Yadukrishnan-KM/automated-solar-dryer-controller-esp32/Final_product_images/IMG_20220216_131751.jpg

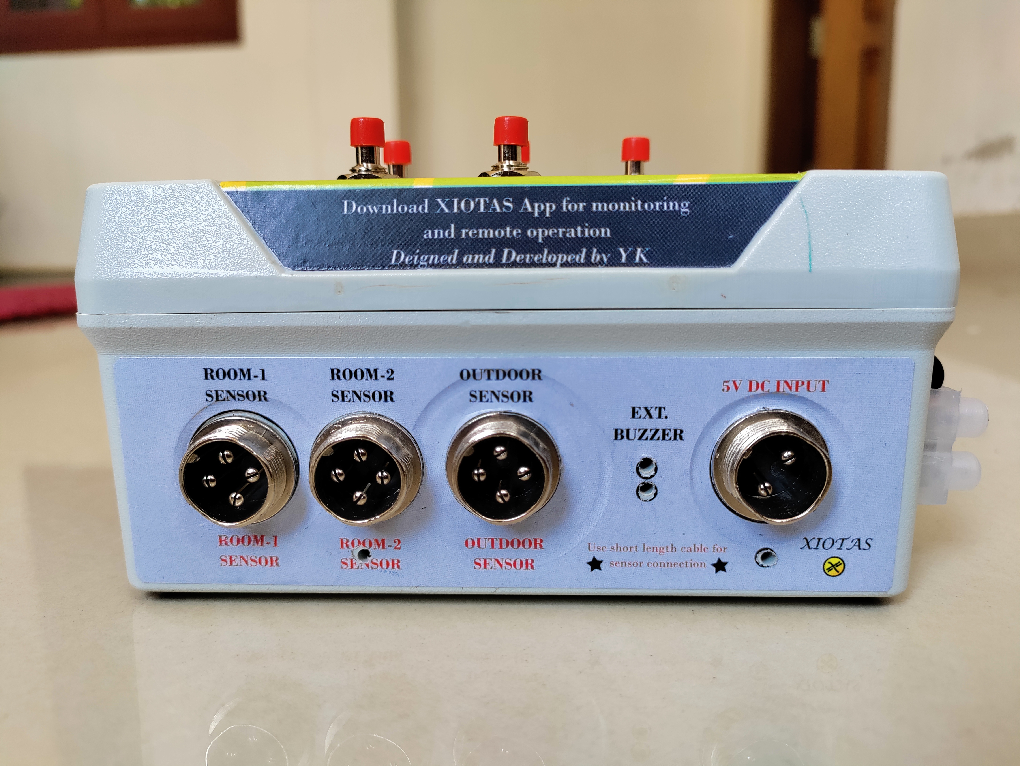
Final_product_images/IMG_20220216_131751.jpg
