Yadukrishnan-KM/automated-solar-dryer-controller-esp32/Final_product_images/IMG_20220226_195927.jpg

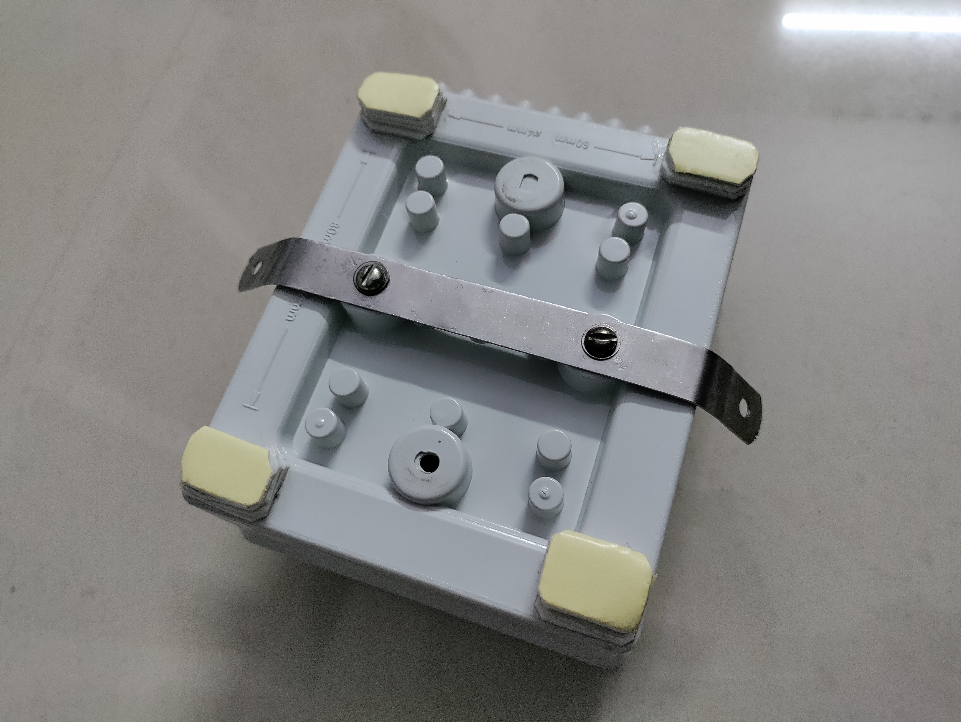
Final_product_images/IMG_20220226_195927.jpg
