Yadukrishnan-KM/automated-solar-dryer-controller-esp32/Firmware/RTC chart.png

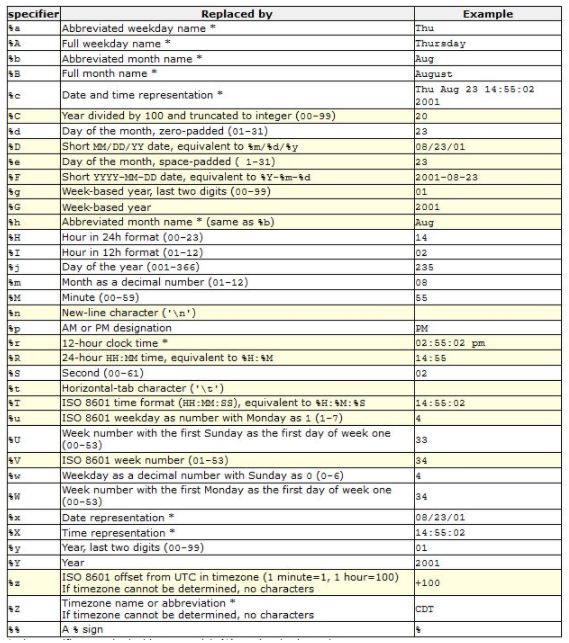
Firmware/RTC chart.png
