Yadukrishnan-KM/automated-solar-dryer-controller-esp32/Hardware/Circuit and pinouts/onoff digital switch circuit diagram.png

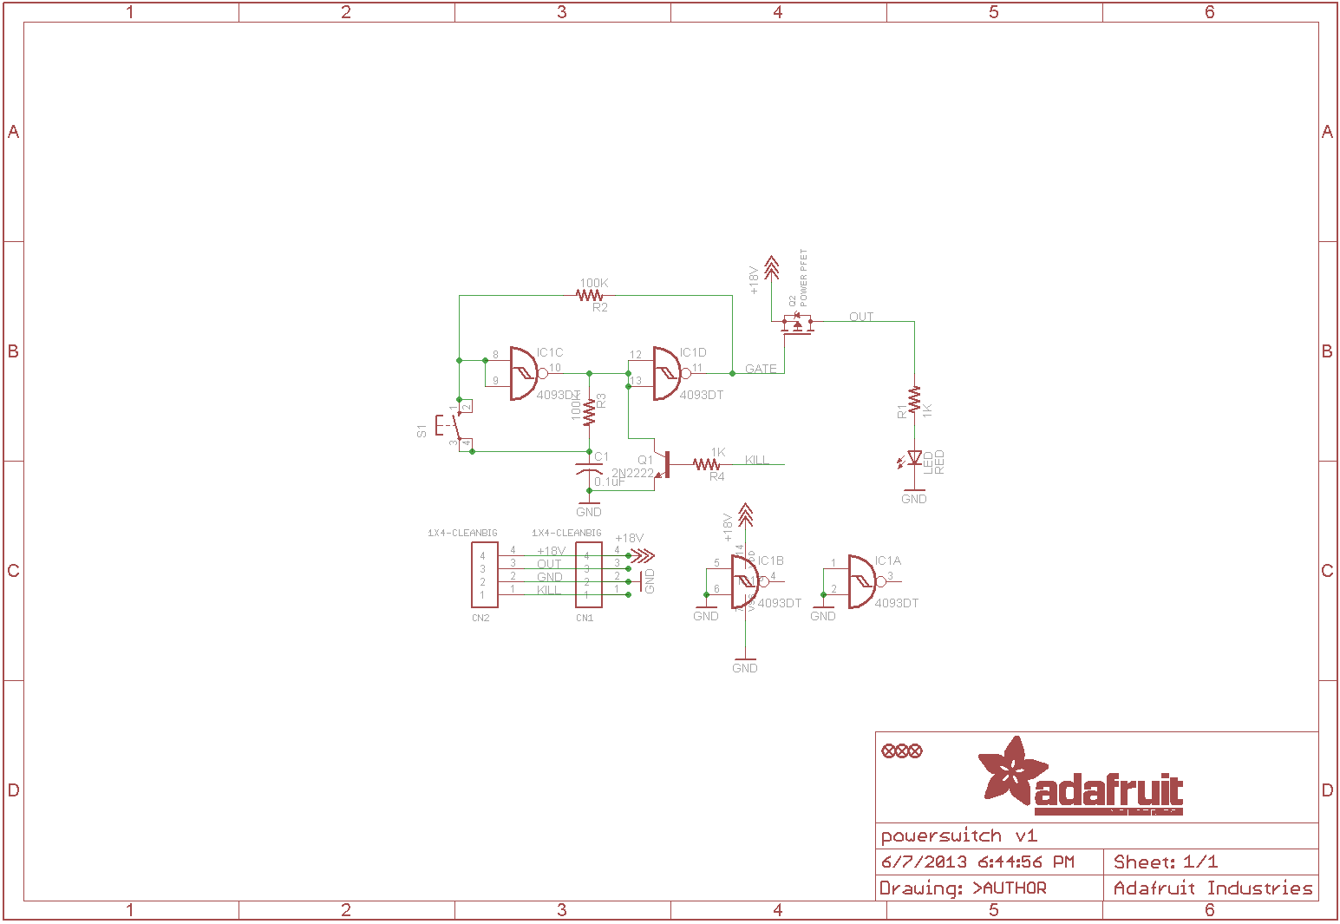
Hardware/Circuit and pinouts/onoff digital switch circuit diagram.png
