Yadukrishnan-KM/automated-solar-dryer-controller-esp32/Hardware/Datasheet/SHT20 Sensor data/wire-diagram.jpg

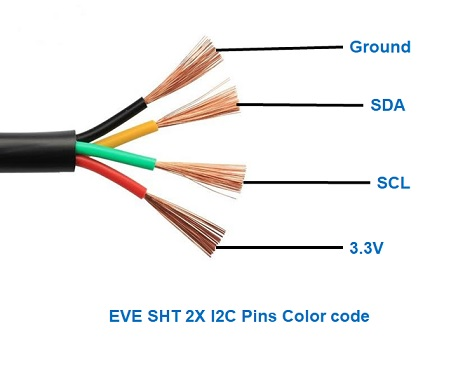
Hardware/Datasheet/SHT20 Sensor data/wire-diagram.jpg
