Yadukrishnan-KM/automated-solar-dryer-controller-esp32/Hardware/Images/IMG-20211218-WA0000.jpeg

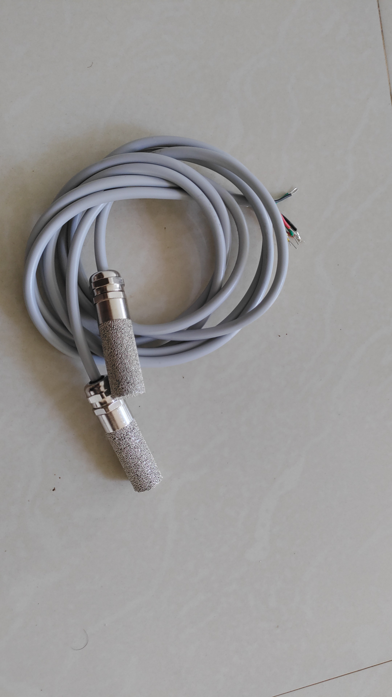
Hardware/Images/IMG-20211218-WA0000.jpeg
