Yadukrishnan-KM/automated-solar-dryer-controller-esp32/Hardware/Images/IMG-20220211-WA0001.jpeg

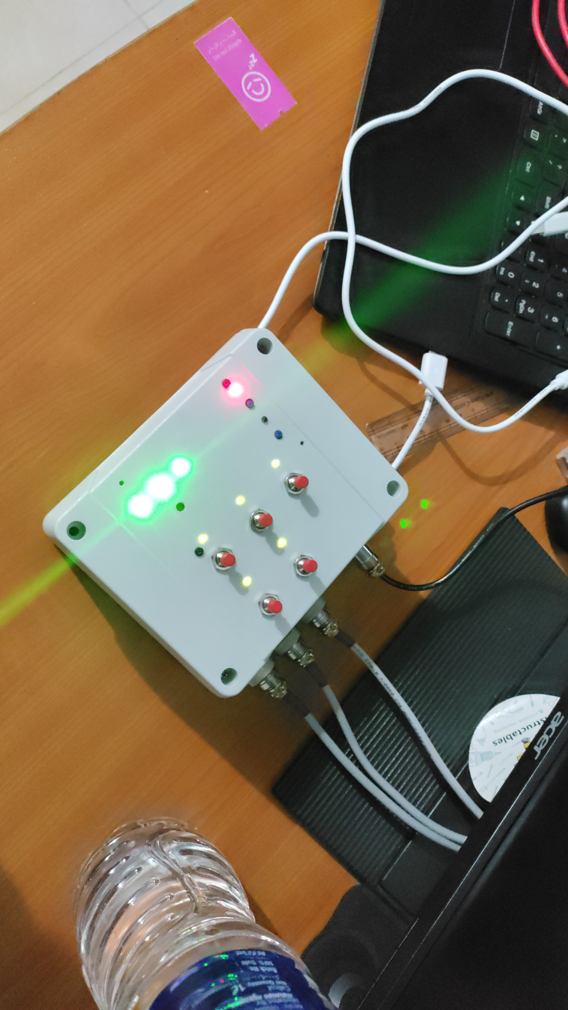
Hardware/Images/IMG-20220211-WA0001.jpeg
