Yadukrishnan-KM/automated-solar-dryer-controller-esp32/Hardware/Images/IMG_20220204_172352.jpg

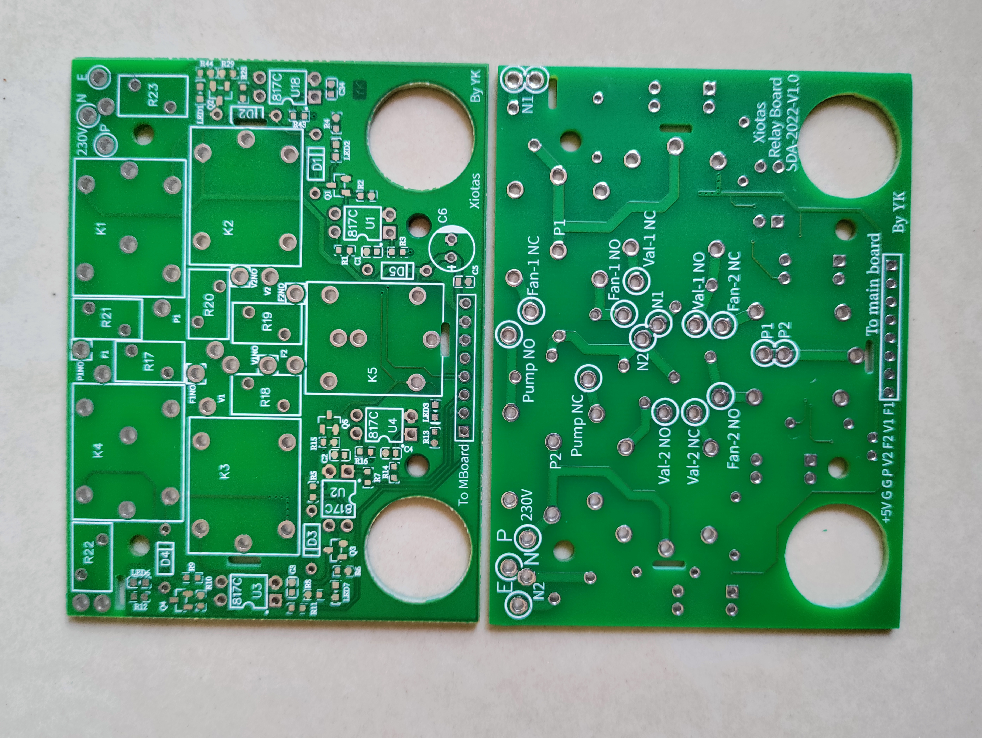
Hardware/Images/IMG_20220204_172352.jpg
