Yadukrishnan-KM/automated-solar-dryer-controller-esp32/Hardware/Images/IMG_20220206_123205.jpg

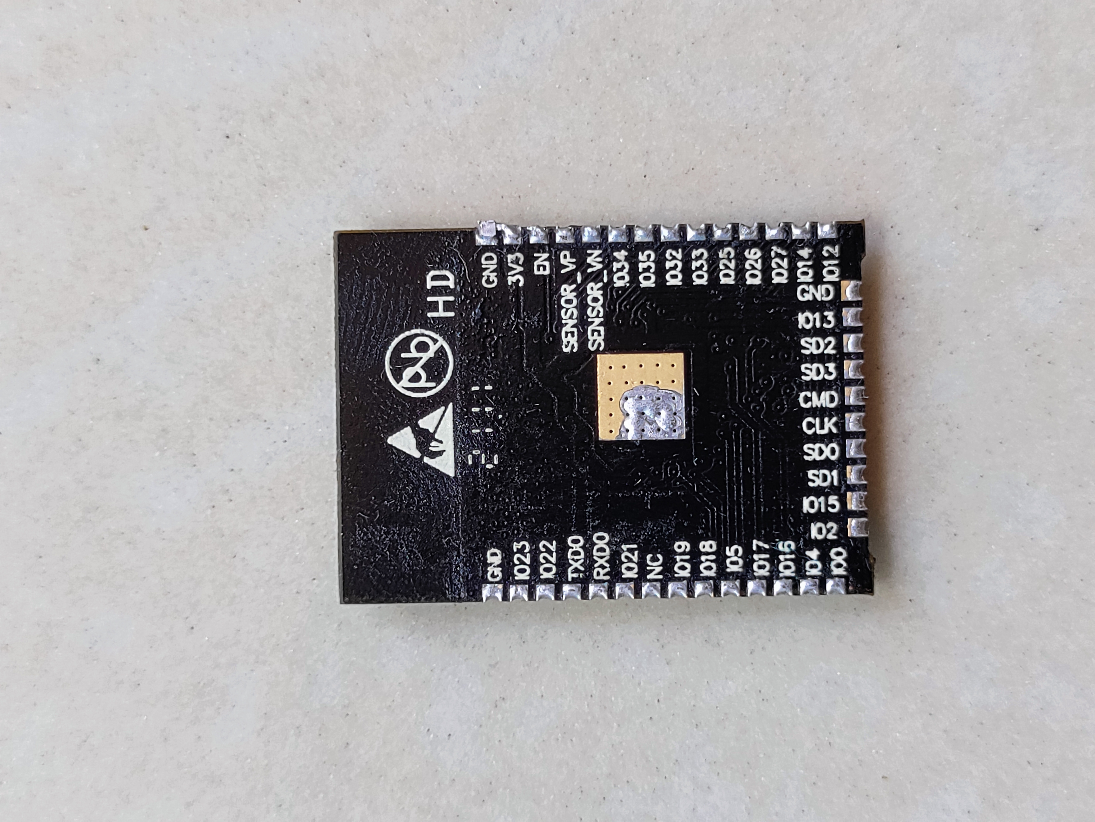
Hardware/Images/IMG_20220206_123205.jpg
