Yadukrishnan-KM/automated-solar-dryer-controller-esp32/Hardware/Images/IMG_20220206_123243.jpg

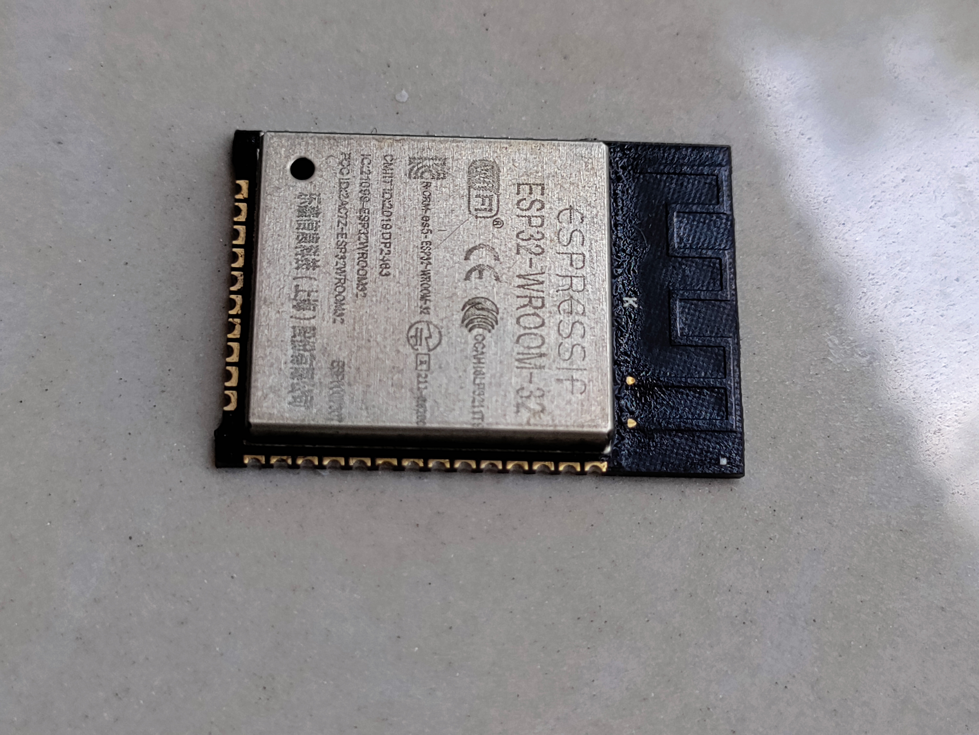
Hardware/Images/IMG_20220206_123243.jpg
