Yadukrishnan-KM/automated-solar-dryer-controller-esp32/Hardware/Images/IMG_20220206_151241.jpg

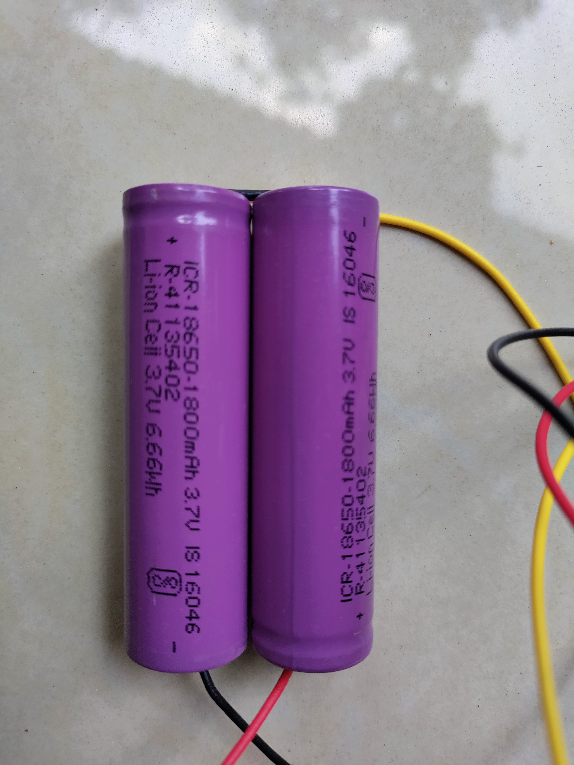
Hardware/Images/IMG_20220206_151241.jpg
