Yadukrishnan-KM/automated-solar-dryer-controller-esp32/Hardware/Images/IMG_20220207_124142.jpg

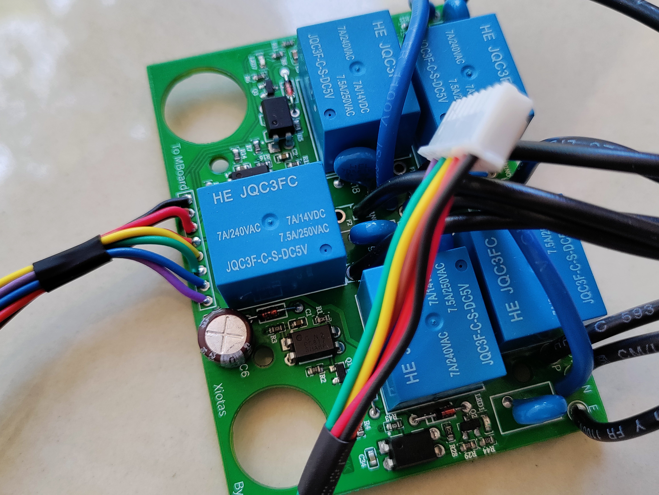
Hardware/Images/IMG_20220207_124142.jpg
