Yadukrishnan-KM/automated-solar-dryer-controller-esp32/Hardware/Images/IMG_20220207_124150.jpg

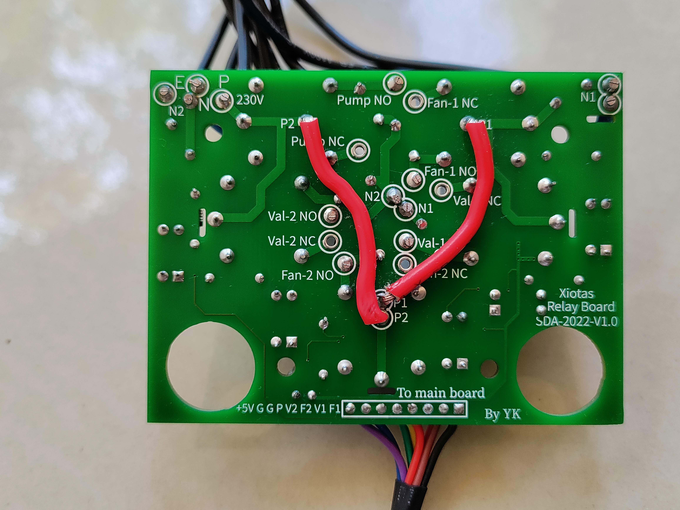
Hardware/Images/IMG_20220207_124150.jpg
