Yadukrishnan-KM/automated-solar-dryer-controller-esp32/Hardware/Images/IMG_20220207_141834.jpg

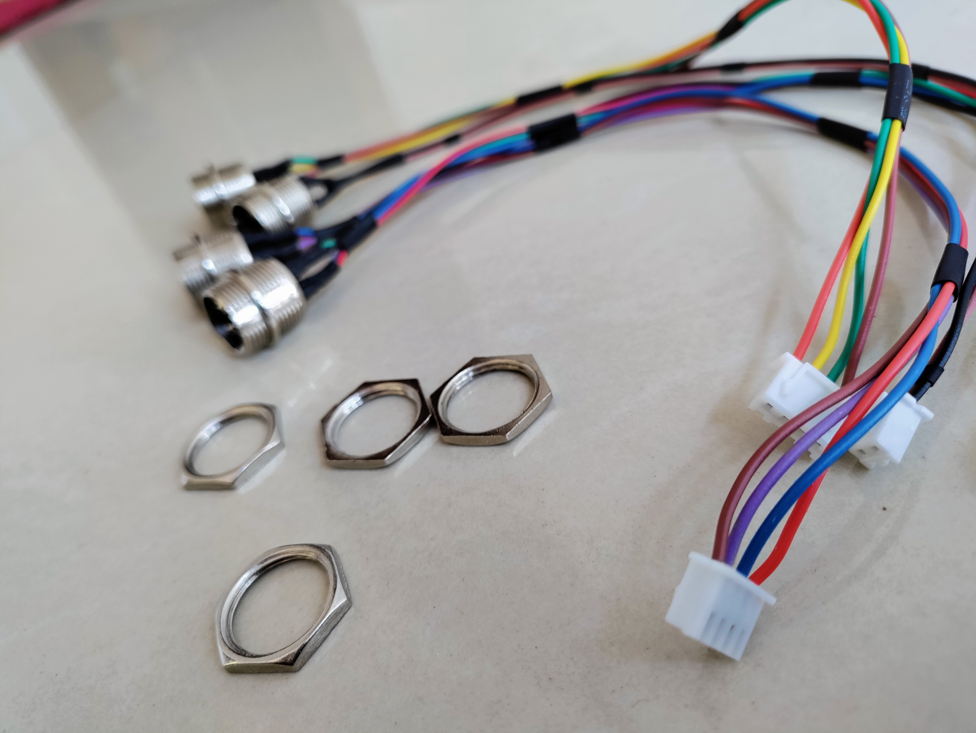
Hardware/Images/IMG_20220207_141834.jpg
