Yadukrishnan-KM/automated-solar-dryer-controller-esp32/Hardware/Images/IMG_20220207_143715.jpg

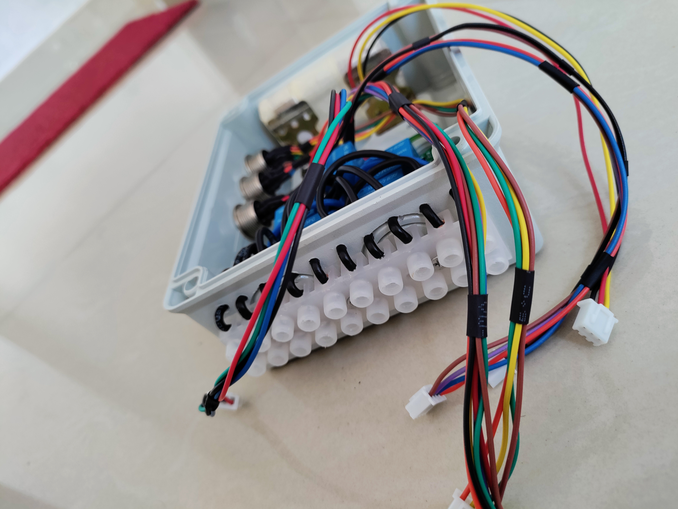
Hardware/Images/IMG_20220207_143715.jpg
