Yadukrishnan-KM/automated-solar-dryer-controller-esp32/Hardware/Images/IMG_20220207_160404.jpg

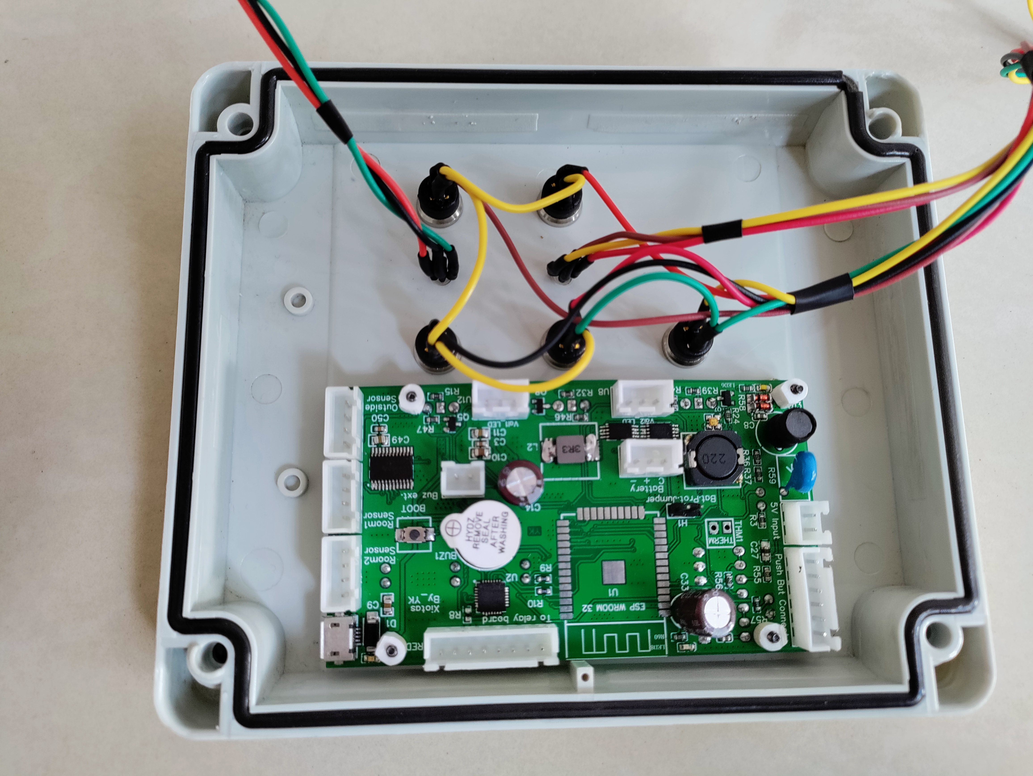
Hardware/Images/IMG_20220207_160404.jpg
