Yadukrishnan-KM/automated-solar-dryer-controller-esp32/Hardware/Images/IMG_20220207_160421.jpg

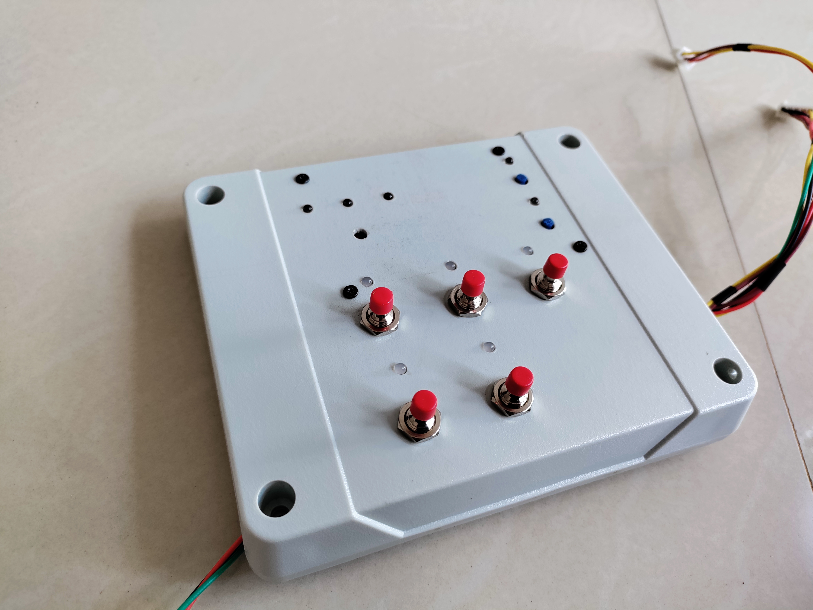
Hardware/Images/IMG_20220207_160421.jpg
