Yadukrishnan-KM/automated-solar-dryer-controller-esp32/Hardware/Images/IMG_20220207_161312.jpg

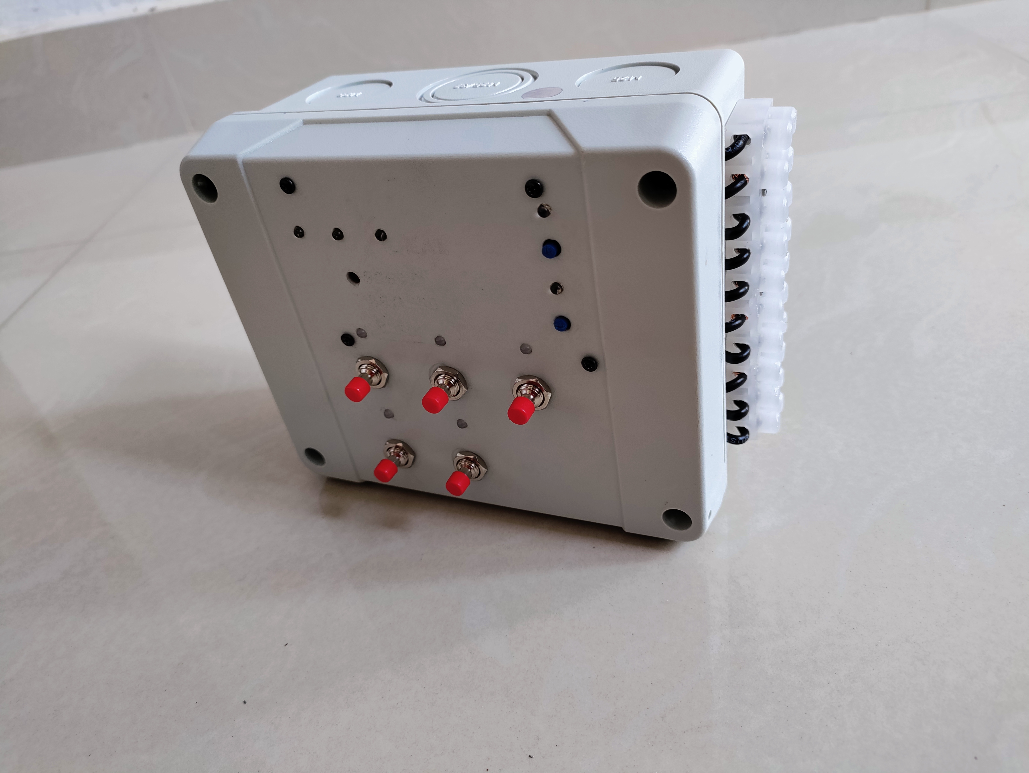
Hardware/Images/IMG_20220207_161312.jpg
