Yadukrishnan-KM/automated-solar-dryer-controller-esp32/Hardware/Images/IMG_20220207_173743.jpg

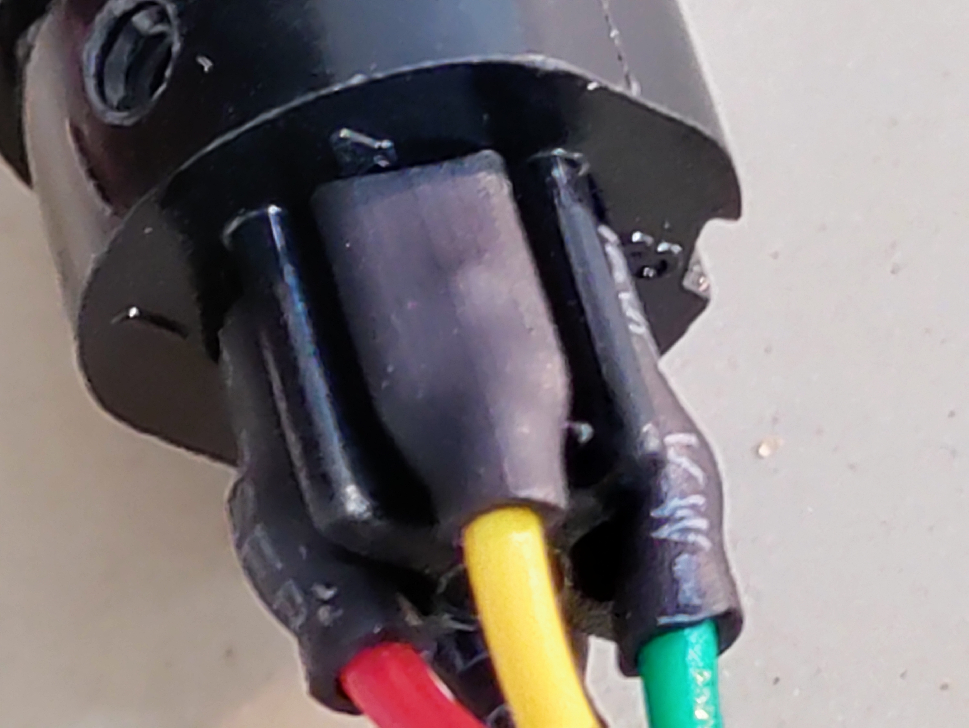
Hardware/Images/IMG_20220207_173743.jpg
