Yadukrishnan-KM/automated-solar-dryer-controller-esp32/Hardware/Images/IMG_20220209_073930.jpg

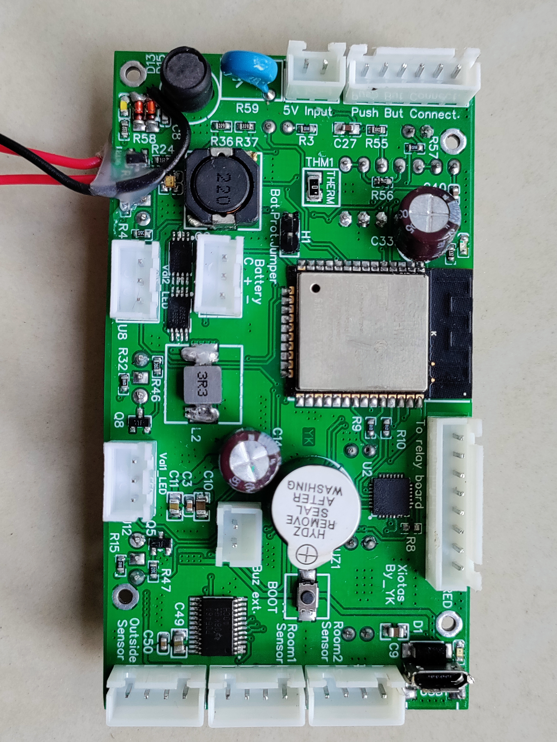
Hardware/Images/IMG_20220209_073930.jpg
