Yadukrishnan-KM/automated-solar-dryer-controller-esp32/Hardware/Images/IMG_20220209_074030.jpg

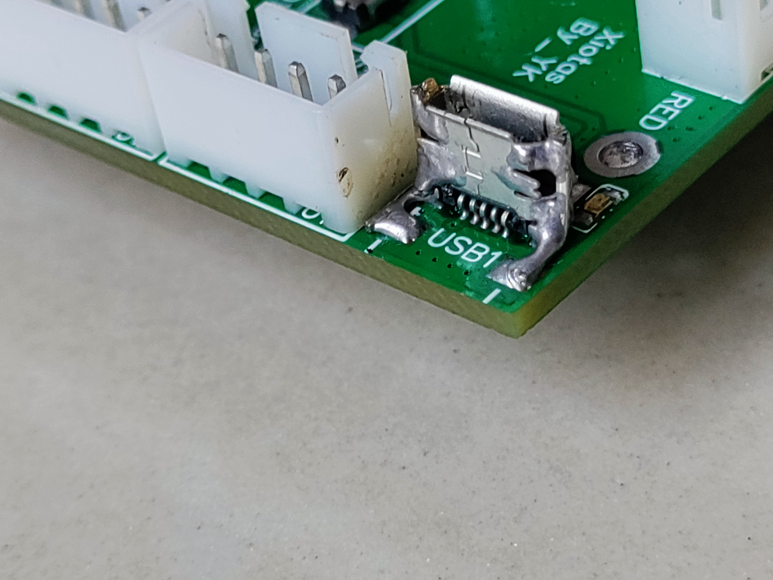
Hardware/Images/IMG_20220209_074030.jpg
