Yadukrishnan-KM/automated-solar-dryer-controller-esp32/Hardware/Images/IMG_20220216_074443.jpg

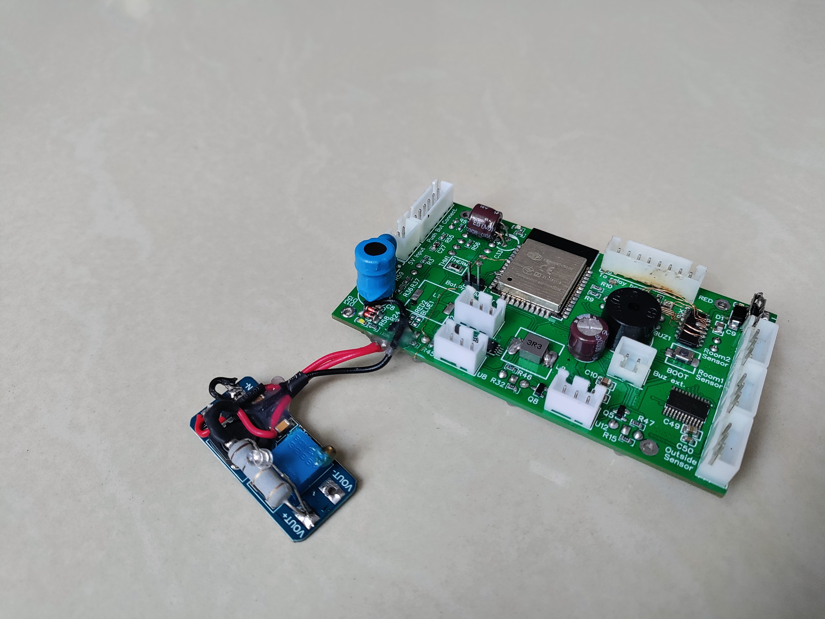
Hardware/Images/IMG_20220216_074443.jpg
