Yadukrishnan-KM/automated-solar-dryer-controller-esp32/Hardware/Images/IMG_20220216_074451.jpg

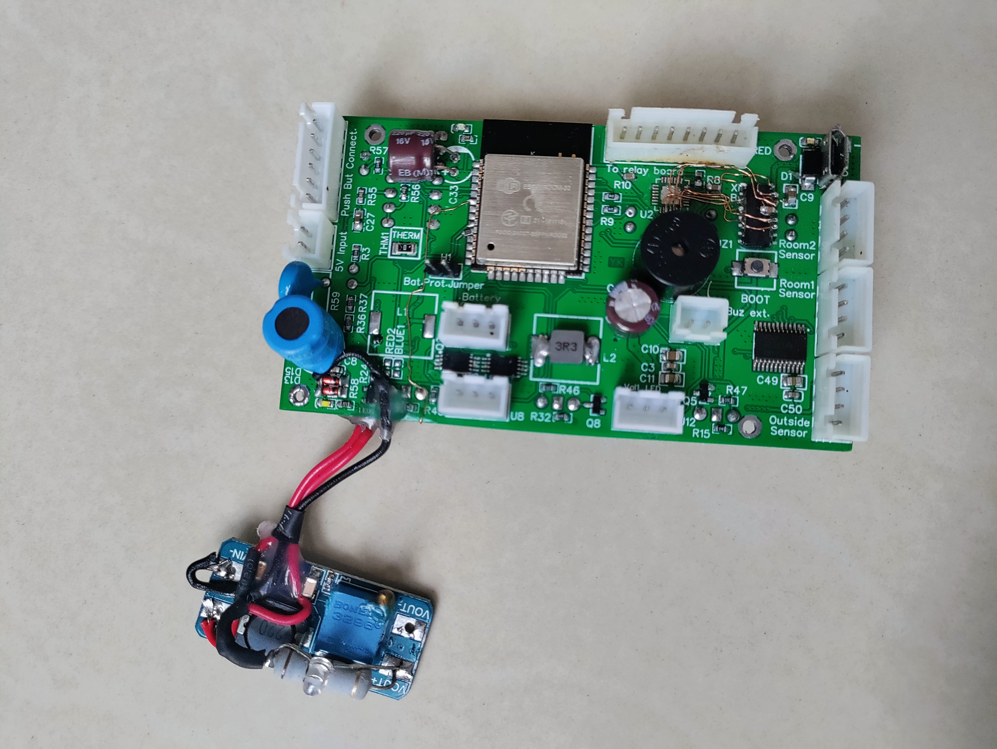
Hardware/Images/IMG_20220216_074451.jpg
