Yadukrishnan-KM/automated-solar-dryer-controller-esp32/Hardware/Images/IMG_20220216_082156.jpg

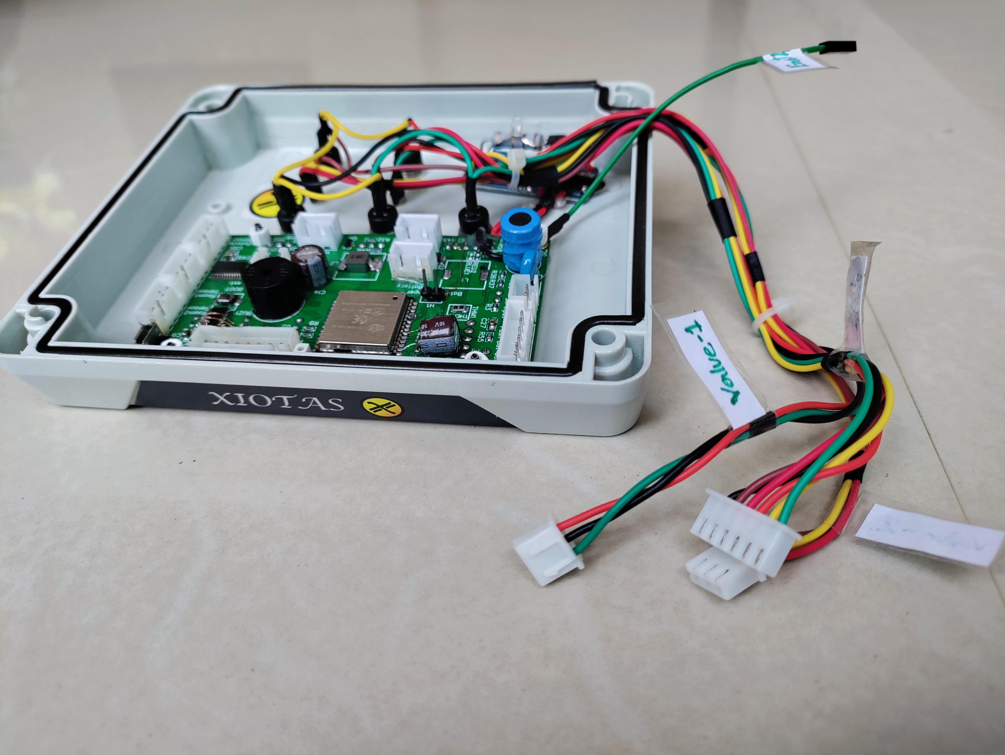
Hardware/Images/IMG_20220216_082156.jpg
