Yadukrishnan-KM/automated-solar-dryer-controller-esp32/Hardware/Images/IMG_20220217_221502.jpg

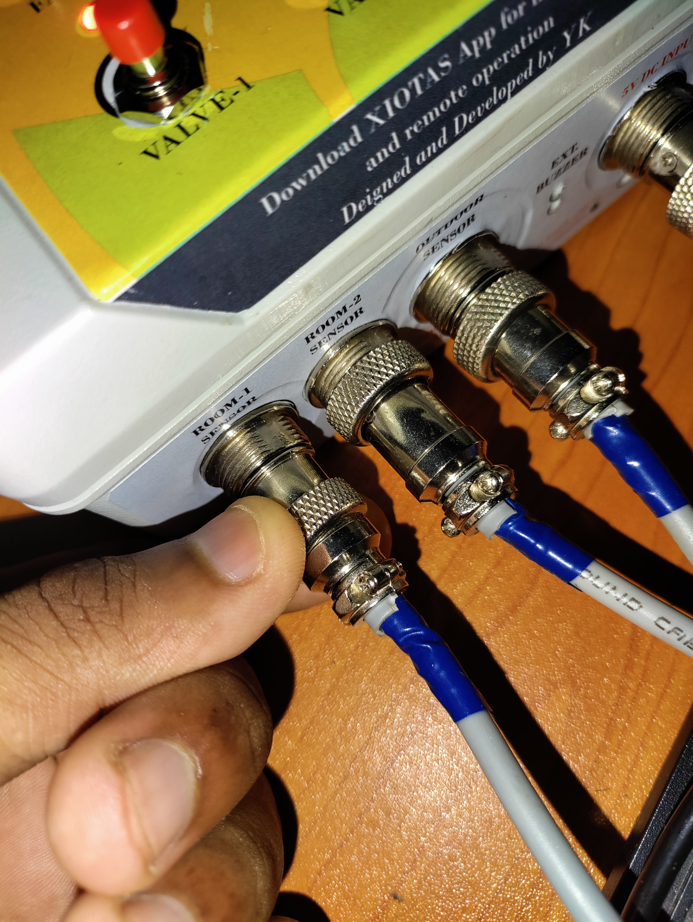
Hardware/Images/IMG_20220217_221502.jpg
