Yadukrishnan-KM/automated-solar-dryer-controller-esp32/Hardware/Images/IMG_20220221_131127.jpg

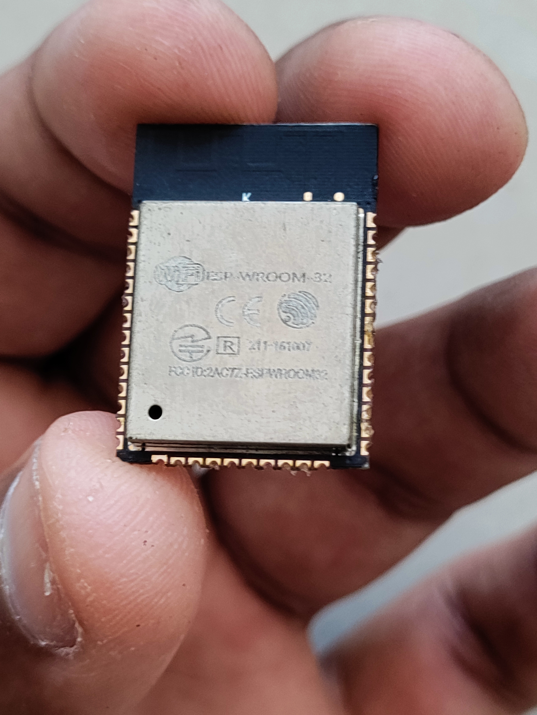
Hardware/Images/IMG_20220221_131127.jpg
