Yadukrishnan-KM/automated-solar-dryer-controller-esp32/Hardware/PCBs Layout/MainPCB_BottomSide.png

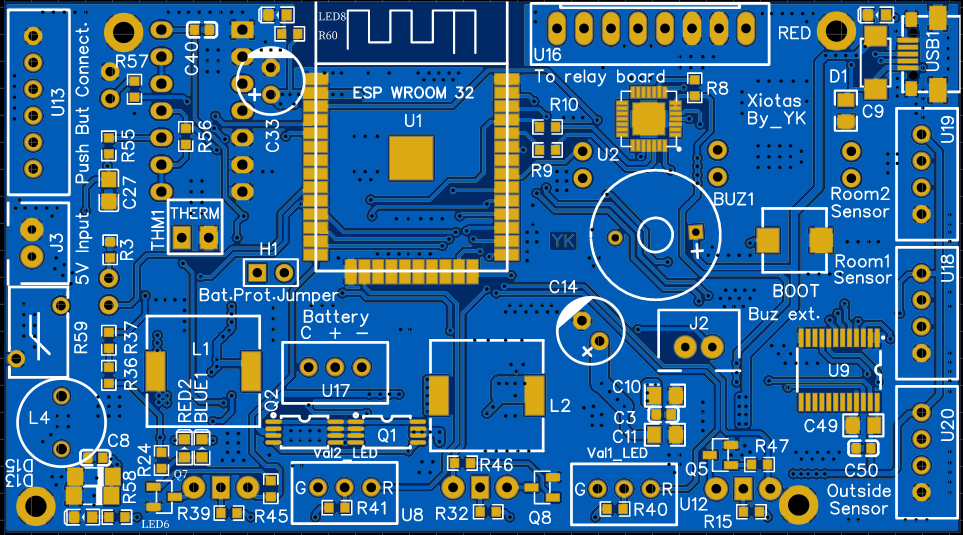
Hardware/PCBs Layout/MainPCB_BottomSide.png
