Yadukrishnan-KM/automated-solar-dryer-controller-esp32/Hardware/PCBs Layout/MainPCB_FrontSide.png

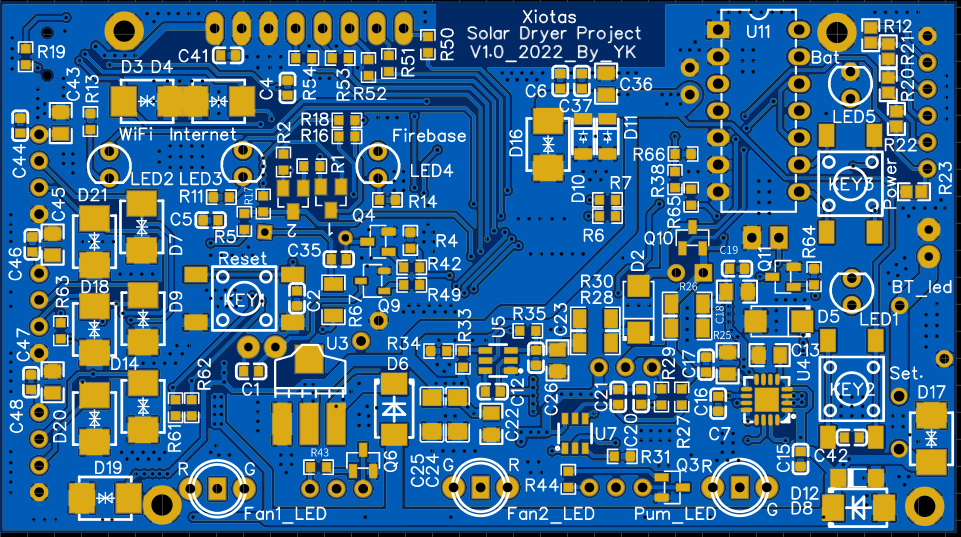
Hardware/PCBs Layout/MainPCB_FrontSide.png
