Yadukrishnan-KM/automated-solar-dryer-controller-esp32/Hardware/PCBs Layout/RelayCntrlPCB_BottomSide.png

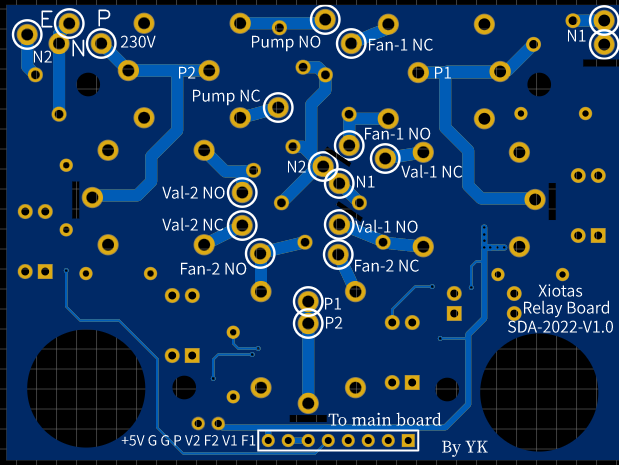
Hardware/PCBs Layout/RelayCntrlPCB_BottomSide.png
