Yadukrishnan-KM/automated-solar-dryer-controller-esp32/Hardware/Schematic_Xiotas_Solar_Dryer_Version_0.1_2022-02-09.png

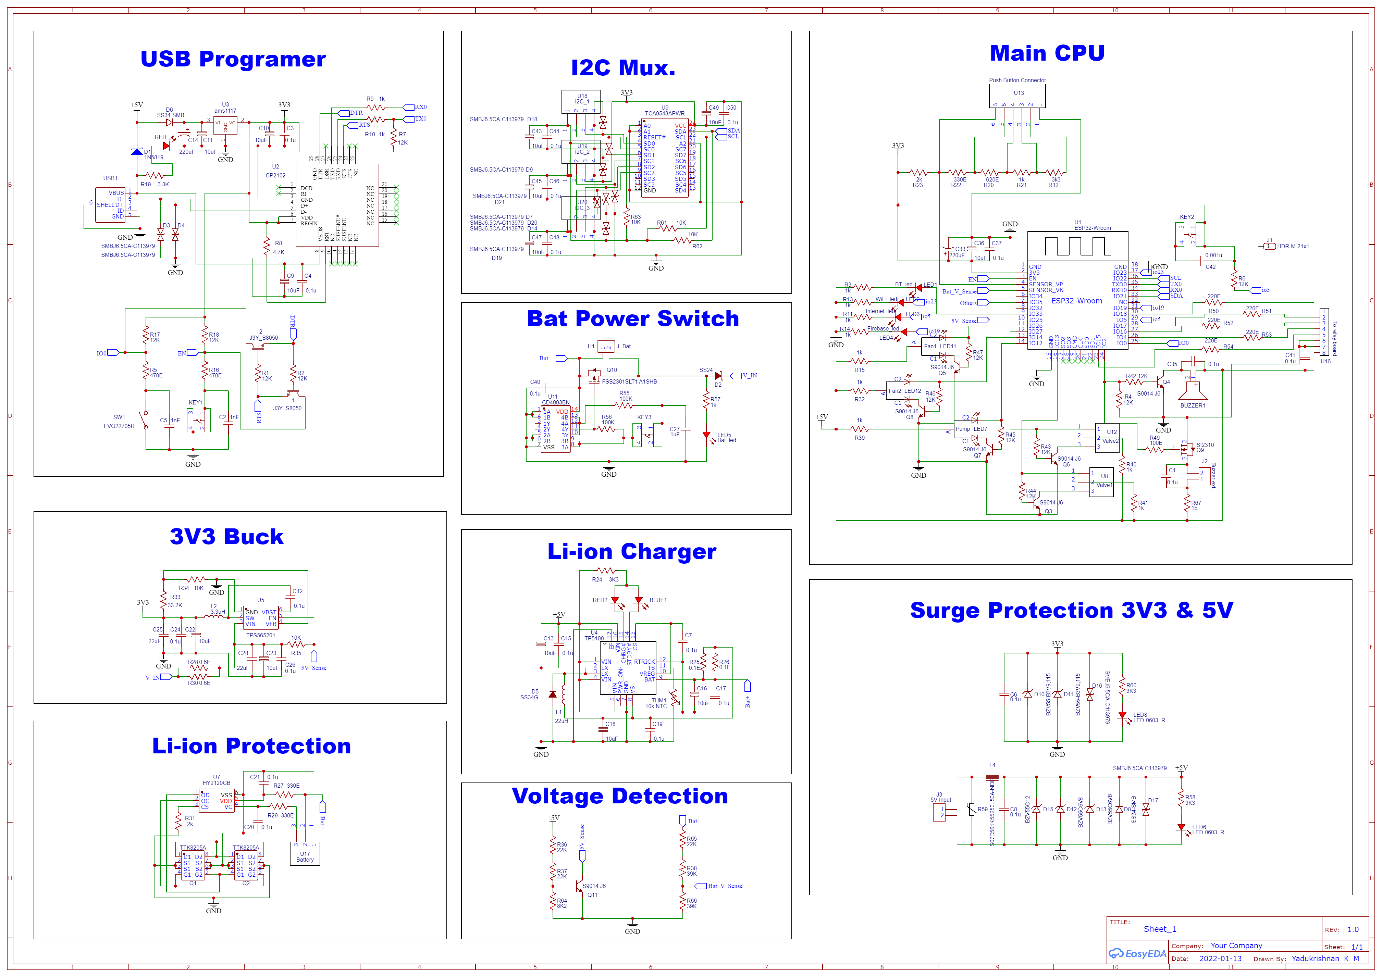
Hardware/Schematic_Xiotas_Solar_Dryer_Version_0.1_2022-02-09.png
