Yadukrishnan-KM/automated-solar-dryer-controller-esp32/Hardware/BOM_PCB_Xiotas_Solar_Dryer_Version_0.1_2022-02-04.csv

쎃슃쎂슃쎃슂쎂슃쎃슃쎂슂쎃슂쎂슿쎃슃쎂슃쎃슂쎂슃쎃슃쎂슂쎃슂쎂슾䤀䐀ⰬName | Designator | Footprint | Quantity | Manufacturer Part
ਢ"∀㄀∢"Ⱜ∀∢0.1u"∀∬∀∢C3 | C8 | C40 | C50 | C46 | C48 | C1 | C4 | C6 | C7 | C12 | C15 | C17 | C19 | C20 | C21 | C26 | C35 | C37 | C41 | C44"∀∬∀∢C0603"∀∬∀∢21"∀∬∀∢"∀∍ਢ"∀㈀∢"Ⱜ∀∢S9014 J6"∀∬∀∢Q5 | Q7 | Q8 | Q3 | Q6 | Q4 | Q11"∀∬∀∢SOT-23-3_L2.9-W1.3-P1.90-LS2.4-BR"∀∬∀∢7"∀∬∀∢S9014LT1 (S9014 J6)"∀∍ਢ"∀㌀∢"Ⱜ∀∢1k"∀∬∀∢R40 | R41 | R3 | R57 | R15 | R32 | R39 | R9 | R10 | R11 | R13 | R14"∀∬∀∢R0603"∀∬∀∢12"∀∬∀∢"∀∍ਢ"∀㐀∢"Ⱜ∀∢LED-0603_R"∀∬∀∢LED8 | LED6 | BLUE1 | RED2 | RED"∀∬∀∢LED0603_RED"∀∬∀∢5"∀∬∀∢19-217/R6C-AL1M2VY/3T"∀∍ਢ"∀㔀∢"Ⱜ∀∢3K3"∀∬∀∢R60 | R58"∀∬∀∢R0603"∀∬∀∢2"∀∬∀∢"∀∍ਢ"∀㘀∢"Ⱜ∀∢10k NTC"∀∬∀∢THM1"∀∬∀∢THERMISTOR"∀∬∀∢1"∀∬∀∢?"∀∍ਢ"∀㜀∢"Ⱜ∀∢10uF"∀∬∀∢C9 | C10 | C11 | C49 | C45 | C47 | C43 | C13 | C16 | C18 | C22 | C23 | C36"∀∬∀∢0805"∀∬∀∢13"∀∬∀∢"∀∍ਢ"∀㠀∢"Ⱜ∀∢TTK8205A"∀∬∀∢Q1 | Q2"∀∬∀∢TSSOP-8_L4.4-W3.0-P0.65-LS6.4-BL"∀∬∀∢2"∀∬∀∢TTK8205A"∀∍ਢ"∀㤀∢"Ⱜ∀∢BZV55C6V8"∀∬∀∢D13 | D12"∀∬∀∢SOD-80_L3.5-W1.5-RD"∀∬∀∢2"∀∬∀∢BZV55C6V8"∀∍ਢ"∀㄀ ∢"Ⱜ∀∢BZV55C12"∀∬∀∢D15"∀∬∀∢SOD-80_L3.5-W1.5-RD"∀∬∀∢1"∀∬∀∢BZV55C12"∀∍ਢ"∀㄀㄀∢"Ⱜ∀∢22K"∀∬∀∢R36 | R37 | R65"∀∬∀∢R0603"∀∬∀∢3"∀∬∀∢"∀∍ਢ"∀㄀㈀∢"Ⱜ∀∢1N5819"∀∬∀∢D1"∀∬∀∢SMA/DO-214AC"∀∬∀∢1"∀∬∀∢"∀∍ਢ"∀㄀㌀∢"Ⱜ∀∢100K"∀∬∀∢R55 | R56"∀∬∀∢R0603"∀∬∀∢2"∀∬∀∢"∀∍ਢ"∀㄀㐀∢"Ⱜ∀∢1uF"∀∬∀∢C27"∀∬∀∢C0805"∀∬∀∢1"∀∬∀∢"∀∍ਢ"∀㄀㔀∢"Ⱜ∀∢Bat.Prot.Jumper"∀∬∀∢H1"∀∬∀∢HDR-F-2.54_1X2"∀∬∀∢1"∀∬∀∢"∀∍ਢ"∀㄀㘀∢"Ⱜ∀∢Buz ext."∀∬∀∢J2"∀∬∀∢JST-2.54-2PIN"∀∬∀∢1"∀∬∀∢"∀∍ਢ"∀㄀㜀∢"Ⱜ∀∢5V Input"∀∬∀∢J3"∀∬∀∢JST-2.54-2PIN"∀∬∀∢1"∀∬∀∢"∀∍ਢ"∀㄀㠀∢"Ⱜ∀∢Valve1"∀∬∀∢U8"∀∬∀∢JST-XH-3PIN"∀∬∀∢1"∀∬∀∢"∀∍ਢ"∀㄀㤀∢"Ⱜ∀∢Valve2"∀∬∀∢U12"∀∬∀∢JST-XH-3PIN"∀∬∀∢1"∀∬∀∢"∀∍ਢ"∀㈀ ∢"Ⱜ∀∢Push But Connect."∀∬∀∢U13"∀∬∀∢JST-XH-6PIN"∀∬∀∢1"∀∬∀∢"∀∍ਢ"∀㈀㄀∢"Ⱜ∀∢To relay board"∀∬∀∢U16"∀∬∀∢JST-XHP-8-PIN"∀∬∀∢1"∀∬∀∢"∀∍ਢ"∀㈀㈀∢"Ⱜ∀∢Battery"∀∬∀∢U17"∀∬∀∢JST-XH-3PIN"∀∬∀∢1"∀∬∀∢"∀∍ਢ"∀㈀㌀∢"Ⱜ∀∢I2C_1"∀∬∀∢U18"∀∬∀∢JST-XH-4PIN"∀∬∀∢1"∀∬∀∢"∀∍ਢ"∀㈀㐀∢"Ⱜ∀∢I2C_2"∀∬∀∢U19"∀∬∀∢JST-XH-4PIN"∀∬∀∢1"∀∬∀∢"∀∍ਢ"∀㈀㔀∢"Ⱜ∀∢I2C_3"∀∬∀∢U20"∀∬∀∢JST-XH-4PIN"∀∬∀∢1"∀∬∀∢"∀∍ਢ"∀㈀㘀∢"Ⱜ∀∢12K"∀∬∀∢R45
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
