Yadukrishnan-KM/automated-solar-dryer-controller-esp32/Stickers/A4 sticker for printing.pdf

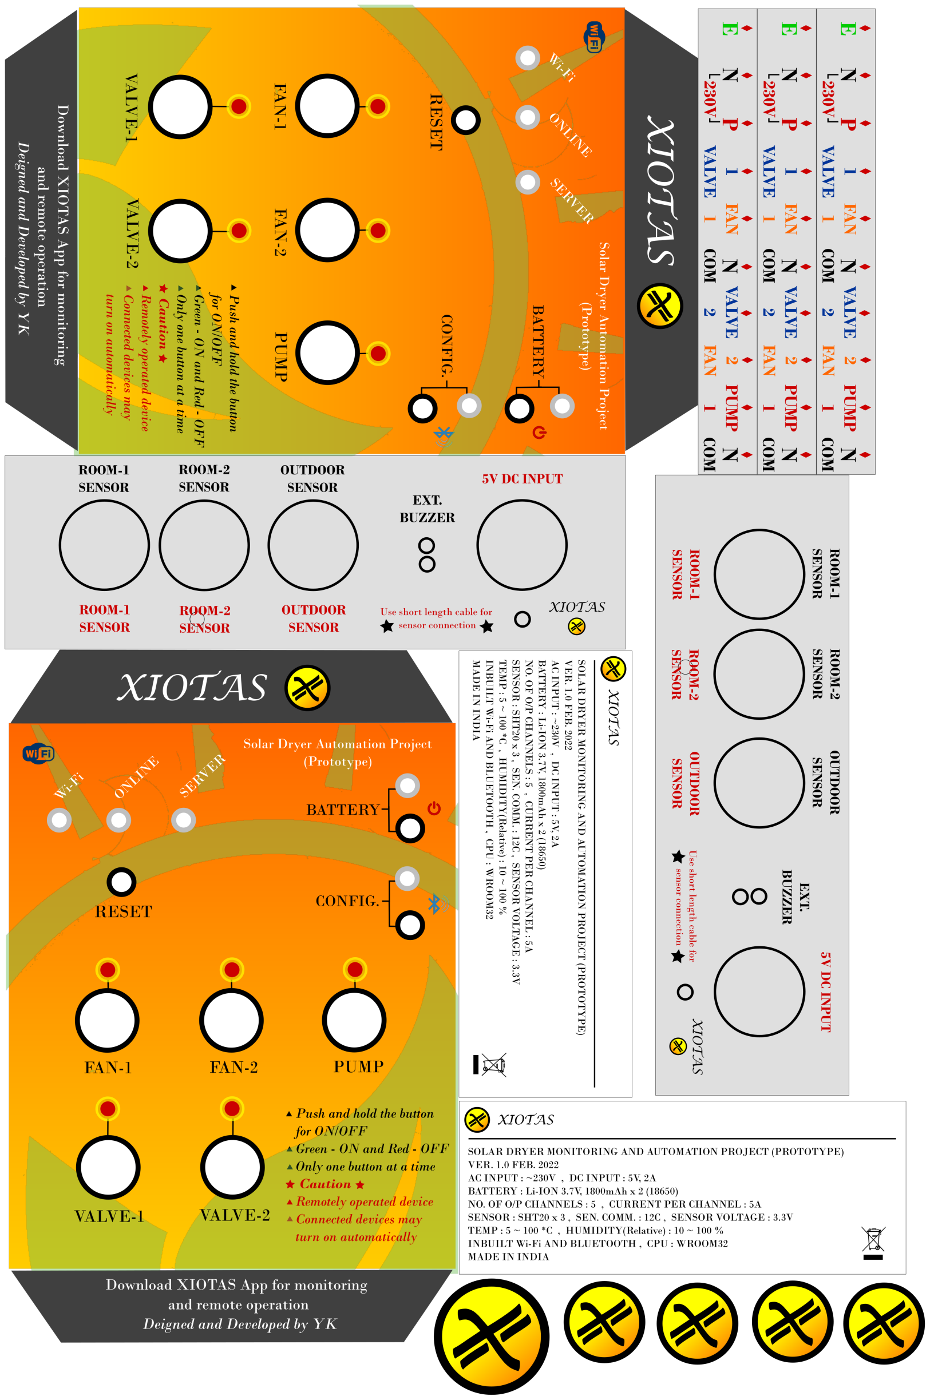
[picture p157: page 1]
