Yadukrishnan-KM/automated-solar-dryer-controller-esp32/Manual/Manual images/Sigin page.png

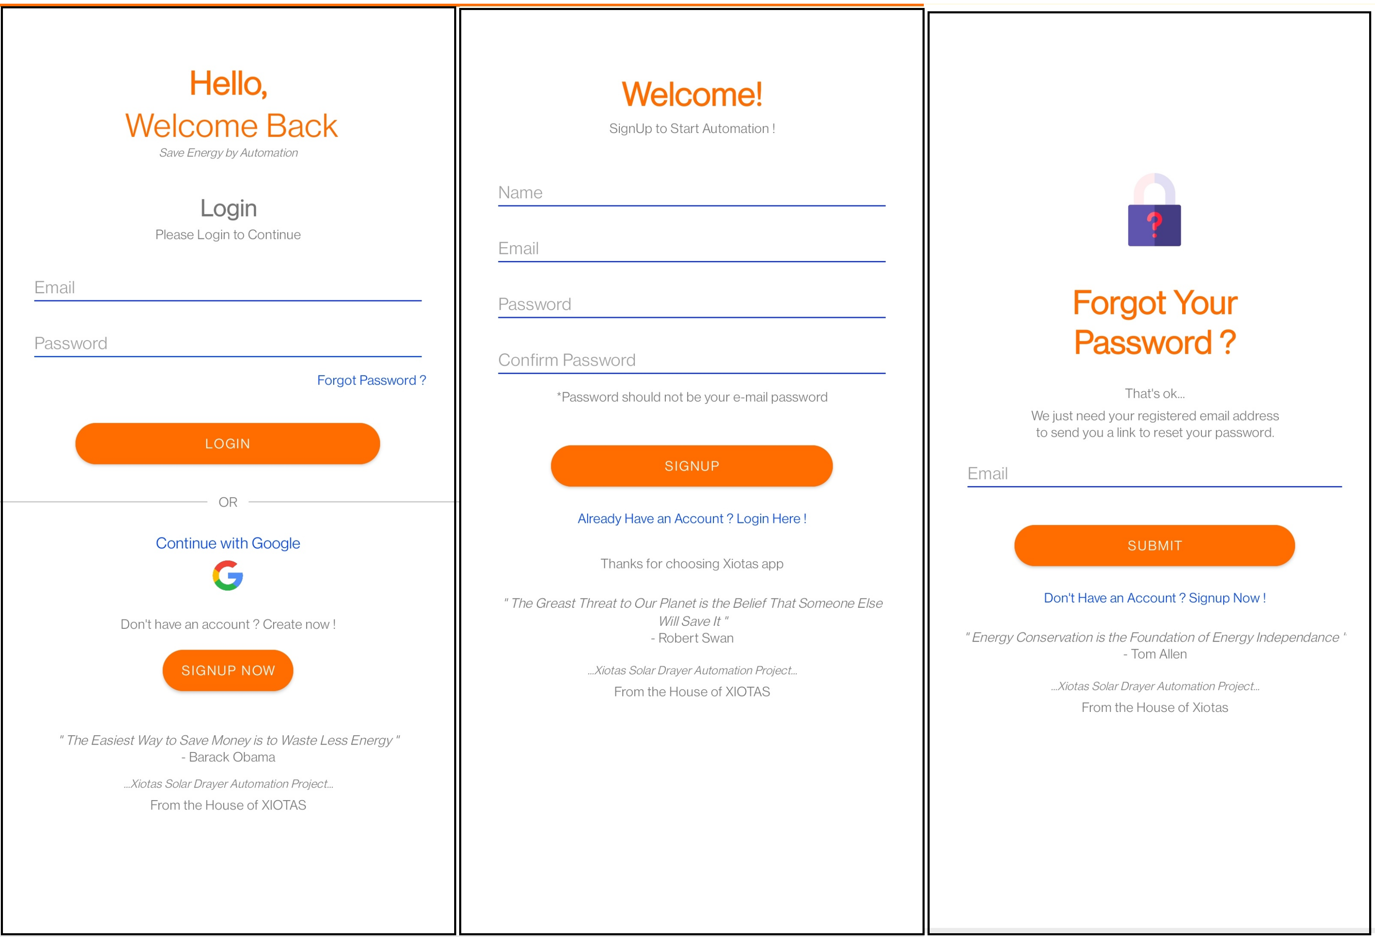
Manual/Manual images/Sigin page.png
