Yadukrishnan-KM/automated-solar-dryer-controller-esp32/Stickers/A4sticker for printing.png

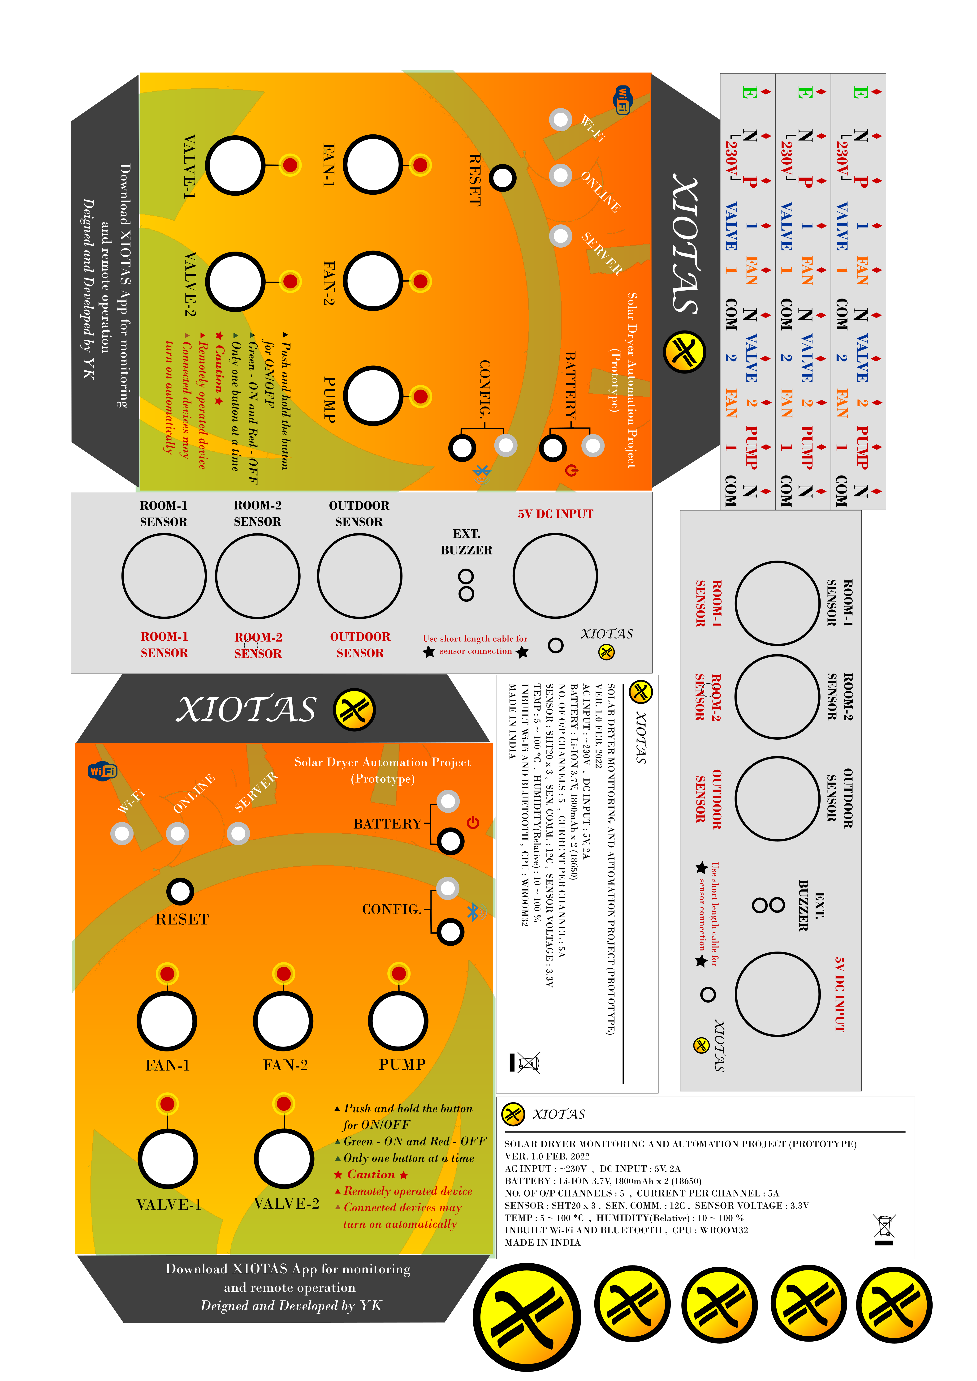
Stickers/A4sticker for printing.png
