Yadukrishnan-KM/automated-solar-dryer-controller-esp32/Hardware/Schematic_Xiotas_Solar_Dryer_Version_0.1_2022-02-09.pdf

USB Programer | Main CPU
I2C Mux.

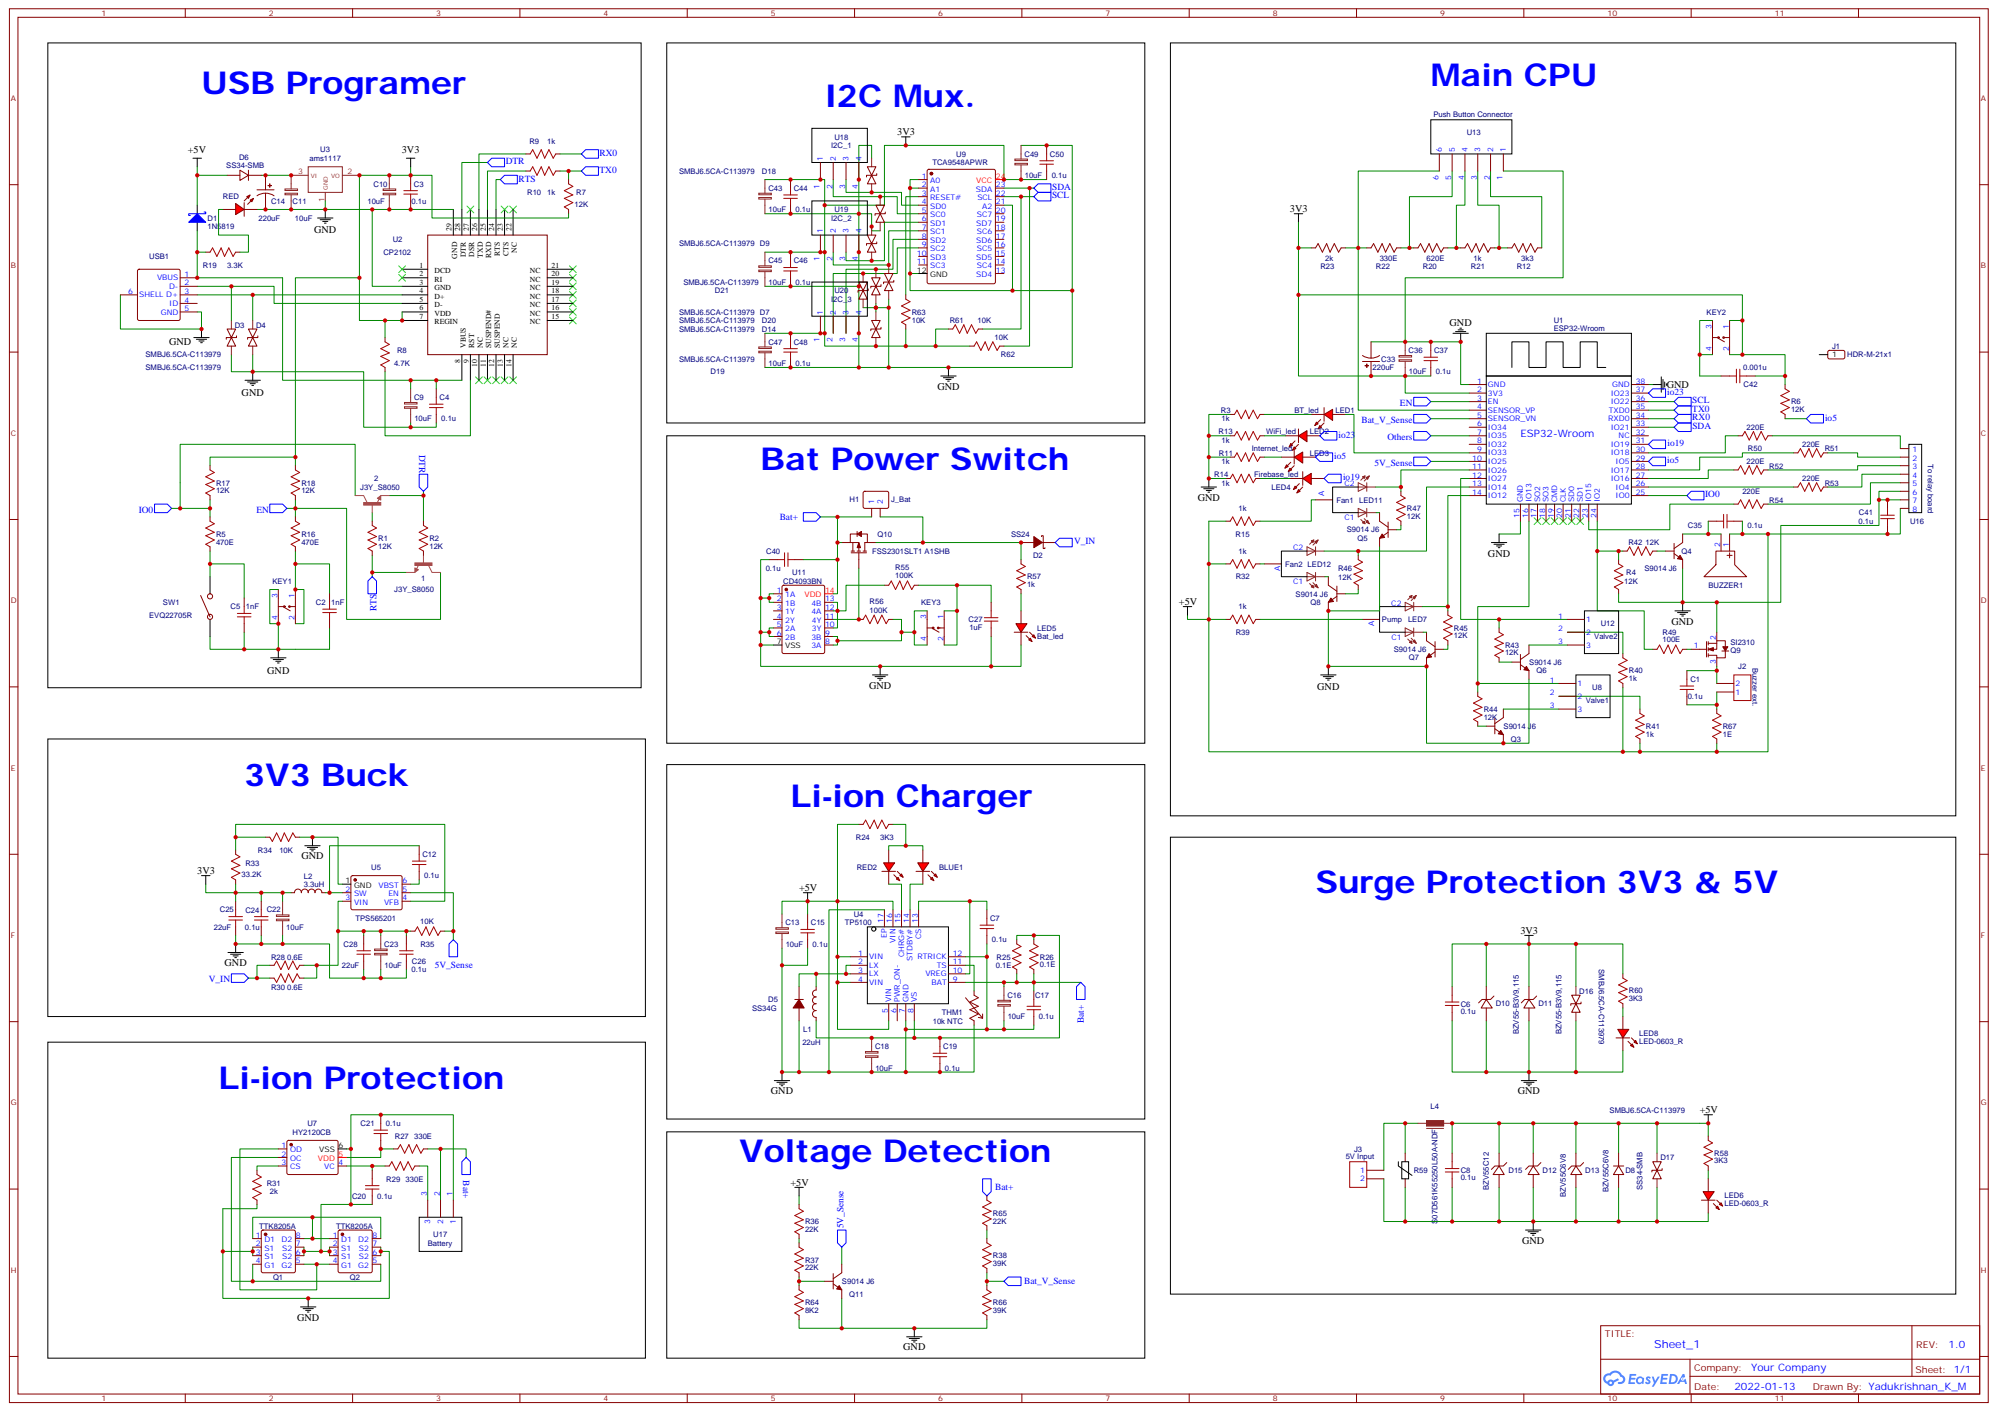
[picture p164: page 1]

CS 13 STDBY# 14 CHRG# 15 VIN 16 EP 17
