Yadukrishnan-KM/automated-solar-dryer-controller-esp32/Stickers/Sticker_Front_Side_Final_Solar dryer project product_v2.pdf

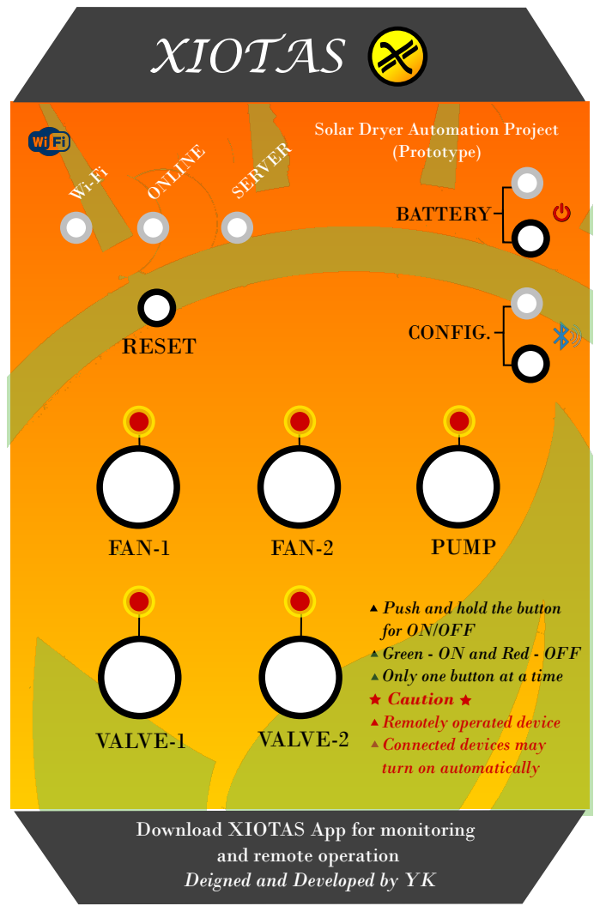
[picture p166: page 1]
BATTERY; CONFIG.; FAN-1; VALVE-1; FAN-2; VALVE-2; PUMP; ONLINE; SERVER; RESET; XIOTAS; (Prototype)

Solar Dryer Automation Project

Push and hold the button
for ON/OFF
Green - ON and Red - OFF
Only one button at a time
Caution
Remotely operated device
Connected devices may
turn on automatically

Download XIOTAS App for monitoring

and remote operation
Deigned and Developed by YK
