Yadukrishnan-KM/automated-solar-dryer-controller-esp32/Manual/solar dryer flowchart.pdf

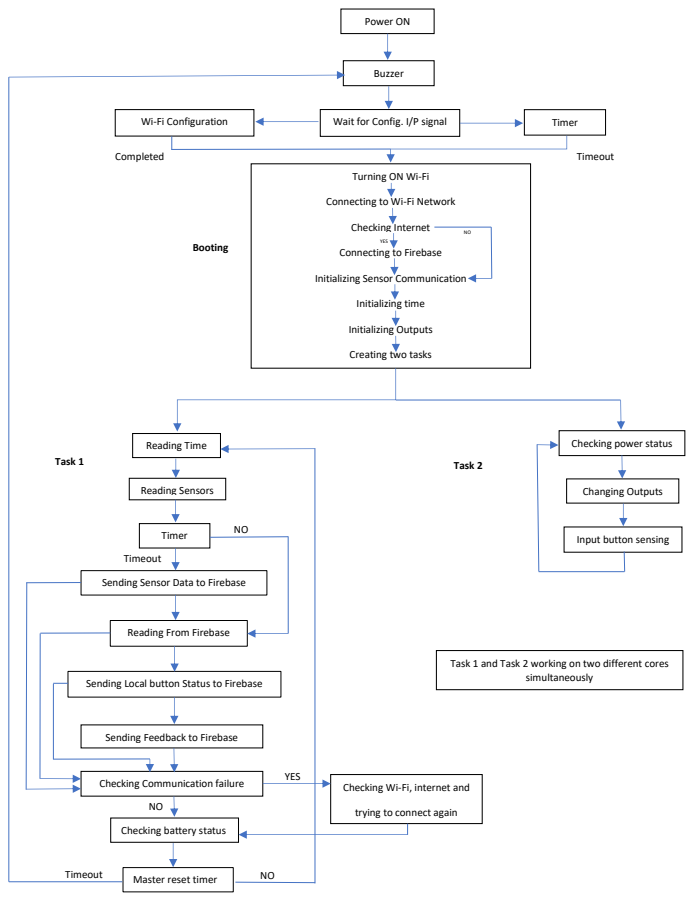
[picture p167: page 1]
YES; Timeout; Completed; Power ON; Buzzer; Wait for Config. I/P signal; Timer; Booting; Checking Internet; Initializing time; Initializing Outputs; Reading Time; Reading Sensors; Task 1; Changing Outputs; Task 2; simultaneously

Wi-Fi Configuration

Turning ON Wi-Fi

Connecting to Wi-Fi Network

Connecting to Firebase

Initializing Sensor Communication

Creating two tasks

Checking power status

Input button sensing

Sending Sensor Data to Firebase

Reading From Firebase

Task 1 and Task 2 working on two different cores

Sending Local button Status to Firebase

Sending Feedback to Firebase

Checking Communication failure

Checking Wi-Fi, internet and

trying to connect again

Checking battery status

Master reset timer
