Yadukrishnan-KM/automated-solar-dryer-controller-esp32/Firmware/Version_0.2_using_sht20/send_sensordata_to_firebase.ino

///////////////////////////////////////////////  Sending sensor data to firebase database             //////////////////////////////////////

boolean writeSensordataFirebase() {

  // room1 old sensor data variables

  static boolean room1oldSensorStatus;
  static float room1oldTemp;
  static float room1oldHumidity;
  static float room1oldMaxTemp;
  static float room1oldMinTemp;
  static float room1oldMaxHumidity;
  static float room1oldMinHumidity;

  // room2 old sensor data variables

  static boolean room2oldSensorStatus;
  static float room2oldTemp;
  static float room2oldHumidity;
  static float room2oldMaxTemp;
  static float room2oldMinTemp;
  static float room2oldMaxHumidity;
  static float room2oldMinHumidity;

  // oustside old sensor data variables

  static boolean outsideoldSensorStatus;
  static float outsideoldTemp;
  static float outsideoldHumidity;
  static float outsideoldMaxTemp;
  static float outsideoldMinTemp;
  static float outsideoldMaxHumidity;
  static float outsideoldMinHumidity;
  if (sensorSatatusCounter) {
    room1oldSensorStatus = !room1SensorStatus;
    room2oldSensorStatus = !room2SensorStatus;
    outsideoldSensorStatus = !outsideSensorStatus;
    sensorSatatusCounter = false;
  }
  if (room1oldSensorStatus != room1SensorStatus ) {
    Firebase.setInt(firebaseData, "/Dryer_Room_1/Sensor_Status", room1SensorStatusInt);
    room1oldSensorStatus = room1SensorStatus;
  }
  if (room1SensorStatus) {
    if (room1oldTemp != room1Temp) Firebase.setFloat(firebaseData, "/Dryer_Room_1/Temperature", room1Temp);
    if (room1oldHumidity !=  room1Humidity) Firebase.setFloat(firebaseData, "/Dryer_Room_1/Humidity", room1Humidity);
    if (room1oldMaxTemp != room1MaxTemp) Firebase.setFloat(firebaseData, "/Dryer_Room_1/Temperature_Max", room1MaxTemp);
    if (room1oldMinTemp != room1MinTemp)Firebase.setFloat(firebaseData, "/Dryer_Room_1/Temperature_Min", room1MinTemp);
    if (room1oldMaxHumidity != room1MaxHumidity)Firebase.setFloat(firebaseData, "/Dryer_Room_1/Humidity_Max", room1MaxHumidity);
    if (room1oldMinHumidity != room1MinHumidity)Firebase.setFloat(firebaseData, "/Dryer_Room_1/Humidity_Min", room1MinHumidity);
    room1oldTemp = room1Temp;
    room1oldHumidity =  room1Humidity;
    room1oldMaxTemp = room1MaxTemp;
    room1oldMinTemp = room1MinTemp;
    room1oldMaxHumidity = room1MaxHumidity;
    room1oldMinHumidity = room1MinHumidity;
  }
  if (room2oldSensorStatus != room2SensorStatus ) {
    Firebase.setInt(firebaseData, "/Dryer_Room_2/Sensor_Status", room2SensorStatusInt);
    room2oldSensorStatus = room2SensorStatus;
  }
  if (room2SensorStatus) {
    if (room2oldTemp != room2Temp) Firebase.setFloat(firebaseData, "/Dryer_Room_2/Temperature", room2Temp);
    if (room2oldHumidity !=  room2Humidity) Firebase.setFloat(firebaseData, "/Dryer_Room_2/Humidity", room2Humidity);
    if (room2oldMaxTemp != room2MaxTemp) Firebase.setFloat(firebaseData, "/Dryer_Room_2/Temperature_Max", room2MaxTemp);
    if (room2oldMinTemp != room2MinTemp)Firebase.setFloat(firebaseData, "/Dryer_Room_2/Temperature_Min", room2MinTemp);
    if (room2oldMaxHumidity != room2MaxHumidity)Firebase.setFloat(firebaseData, "/Dryer_Room_2/Humidity_Max", room2MaxHumidity);
    if (room2oldMinHumidity != room2MinHumidity)Firebase.setFloat(firebaseData, "/Dryer_Room_2/Humidity_Min", room2MinHumidity);
    room2oldTemp = room2Temp;
    room2oldHumidity =  room2Humidity;
    room2oldMaxTemp = room2MaxTemp;
    room2oldMinTemp = room2MinTemp;
    room2oldMaxHumidity = room2MaxHumidity;
    room2oldMinHumidity = room2MinHumidity;
  }
  if (outsideoldSensorStatus != outsideSensorStatus ) {
    Firebase.setInt(firebaseData, "/Outside/Sensor_Status", outsideSensorStatusInt);
    outsideoldSensorStatus = outsideSensorStatus;
  }
  if (outsideSensorStatus) {
    if (outsideoldTemp != outsideTemp) Firebase.setFloat(firebaseData, "/Outside/Temperature", outsideTemp);
    if (outsideoldHumidity !=  outsideHumidity) Firebase.setFloat(firebaseData, "/Outside/Humidity", outsideHumidity);
    if (outsideoldMaxTemp != outsideMaxTemp) Firebase.setFloat(firebaseData, "/Outside/Temperature_Max", outsideMaxTemp);
    if (outsideoldMinTemp != outsideMinTemp)Firebase.setFloat(firebaseData, "/Outside/Temperature_Min", outsideMinTemp);
    if (outsideoldMaxHumidity != outsideMaxHumidity)Firebase.setFloat(firebaseData, "/Outside/Humidity_Max", outsideMaxHumidity);
    if (outsideoldMinHumidity != outsideMinHumidity)Firebase.setFloat(firebaseData, "/Outside/Humidity_Min", outsideMinHumidity);
    outsideoldTemp = outsideTemp;
    outsideoldHumidity =  outsideHumidity;
    outsideoldMaxTemp = outsideMaxTemp;
    outsideoldMinTemp = outsideMinTemp;
    outsideoldMaxHumidity = outsideMaxHumidity;
    outsideoldMinHumidity = outsideMinHumidity;
  }


  if (Firebase.setString(firebaseData, "/Others/Last_Updated", lastUpdatedDateTime)) {
    Serial.println("Writing sensor data to firebase was successfull");
    digitalWrite( firebaseLedPin, LOW);
    delay(50);
    digitalWrite( firebaseLedPin, HIGH);
    delay(50);
    digitalWrite( firebaseLedPin, LOW);
    delay(50);
    digitalWrite( firebaseLedPin, HIGH);
    return true;
  }
  else return false;

}

///////////////////////////////////////////////  Sending device feedback to firebase database             //////////////////////////////////////

boolean sendDeviceFeedbackFirebase() {
  if (!Firebase.setInt(firebaseData, "/Dryer_Room_1/Fan_Feedback", room1FanFeedback)) return false;
  if (!Firebase.setInt(firebaseData, "/Dryer_Room_1/Valve_Feedback", room1ValveFeedback)) return false;
  if (!Firebase.setInt(firebaseData, "/Dryer_Room_2/Fan_Feedback", room2FanFeedback)) return false;
  if (!Firebase.setInt(firebaseData, "/Dryer_Room_2/Valve_Feedback", room2ValveFeedback)) return false;
  if (!Firebase.setInt(firebaseData, "/Outside/Pump_Feedback", outsidePumpFeedback)) return false;
  Serial.println("Writing Device Feedback to firebase was successfull");
  digitalWrite( firebaseLedPin, LOW);
  delay(50);
  digitalWrite( firebaseLedPin, HIGH);
  delay(50);
  digitalWrite( firebaseLedPin, LOW);
  delay(50);
  digitalWrite( firebaseLedPin, HIGH);
  return true;
}

boolean sendLocalSwitchDtataChange() {
  int room1FanStatusInt;
  int room1ValveStatusInt;
  int room2FanStatusInt;
  int room2ValveStatusInt;
  int outsidePumpStatusInt;
  //Serial.println("Entered in sendLocalSwitchDtataChange");
  if (localSwitchRoom1FanStateChange = true) {
    if (room1FanStatus) room1FanStatusInt = 1;
    else if (!room1FanStatus) room1FanStatusInt = 0;
    if (!Firebase.setInt(firebaseData, "/Dryer_Room_1/Fan_Status", room1FanStatusInt)) return false;
    localSwitchRoom1FanStateChange = false;
  }
  if (localSwitchRoom1ValveStateChange = true) {
    if (room1ValveStatus) room1ValveStatusInt = 1;
    else if (!room1ValveStatus) room1ValveStatusInt = 0;
    if (!Firebase.setInt(firebaseData, "/Dryer_Room_1/Valve_Status", room1ValveStatusInt)) return false;
    localSwitchRoom1ValveStateChange = false;
  }
  if (localSwitchRoom2FanStateChange = true) {
    if (room2FanStatus) room2FanStatusInt = 1;
    else if (!room2FanStatus) room2FanStatusInt = 0;
    if (!Firebase.setInt(firebaseData, "/Dryer_Room_2/Fan_Status", room2FanStatusInt)) return false;
    localSwitchRoom2FanStateChange = false;
  }
  if (localSwitchRoom2ValveStateChange = true) {
    if (room2ValveStatus) room2ValveStatusInt = 1;
    else if (!room2ValveStatus) room2ValveStatusInt = 0;
    if (!Firebase.setInt(firebaseData, "/Dryer_Room_2/Valve_Status", room2ValveStatusInt)) return false;
    localSwitchRoom2ValveStateChange = false;
  }
  if (localSwitchOutsidePumpStateChange = true) {
    if (outsidePumpStatus) outsidePumpStatusInt = 1;
    else if (!outsidePumpStatus) outsidePumpStatusInt = 0;
    if (!Firebase.setInt(firebaseData, "/Outside/Pump_Status", outsidePumpStatusInt)) return false;
    localSwitchOutsidePumpStateChange = false;
    //Serial.print("localSwitchRoom1FanStateChange"); Serial.println(localSwitchOutsidePumpStateChange);
  }

  //Serial.println("Completed sendLocalSwitchDtataChange");
  Serial.println("Writing Local Switch tata Change to firebase was successfull");
  digitalWrite( firebaseLedPin, LOW);
  delay(50);
  digitalWrite( firebaseLedPin, HIGH);
  delay(50);
  digitalWrite( firebaseLedPin, LOW);
  delay(50);
  digitalWrite( firebaseLedPin, HIGH);
  return true;
}

///////////////////////////////////////////////  Sending battery voltage to firebase database             //////////////////////////////////////

void sendBatteryPercentage() {
  static int oldBatteryPercent;
  if (oldBatteryPercent != batteryPercent) {
    Firebase.setFloat(firebaseData, "/Others/Battery_Voltage", batteryPercent);
    oldBatteryPercent = batteryPercent;
  }
}
