Yadukrishnan-KM/automated-solar-dryer-controller-esp32/Firmware/Version 0.1 using sht20/Version_0.1_using_sht20/RTCwithNTC_server.ino

void printLocalTime()
{
  struct tm timeinfo;
  if (!getLocalTime(&timeinfo)) {
    Serial.println("Failed to obtain time");
    return;
  }
  char dateTime[26];
  strftime(dateTime, 26 , "%d %b %Y %r", &timeinfo);
  //Serial.println(dateTime);
  lastUpdatedDateTime = String(dateTime);
  //Serial.println(&timeinfo, "%d %b %Y %r");
}
