Yadukrishnan-KM/automated-solar-dryer-controller-esp32/Firmware/Version 0.1 using sht20/Version_0.1_using_sht20/Task_for_2nd_core.ino

void Task1code( void * parameter ) {
  Serial.print("Task1 is running on core ");
  Serial.println(xPortGetCoreID());

  for (;;) {
    room1FanFeedback = room1FanOutputControl();
    room1ValveFeedback = room1ValveOutputControl();
    room2FanFeedback = room2FanOutputControl();
    room2ValveFeedback = room2ValveOutputControl();
    outsidePumpFeedback = outsidePumpOutputControl();
    if(room1FanFeedback == 2 || room1ValveFeedback == 2 || room2FanFeedback == 2 || room2ValveFeedback == 2 || outsidePumpFeedback == 2) buzzer.ledBlink (HIGH, 500);
    else buzzer.cancelLedBlink(LOW);
    localControlButtonRead();
    delay(16);
  }
}
