Yadukrishnan-KM/automated-solar-dryer-controller-esp32/Firmware/Trial code fragments/Sample/Wifi setup using bth and eeprom/sketch_dec16a/sketch_dec16a.ino

#include "BluetoothSerial.h" //Header File for Serial Bluetooth, will be added by default into Arduino
#include <EEPROM.h>
#include "WiFi.h"
BluetoothSerial ESP_BT; //Object for Bluetooth
String buffer_in;
unsigned long previousMillis = 0; 
byte val;       
int addr = 0;
byte indS=0;
byte indP=0;
String stream;
byte len=0;
String temp;
String temp2;
unsigned int interval=30000;
void setup() {
EEPROM.begin(50);
Serial.begin(9600); //Start Serial monitor in 9600
    Serial.println("Bluetooth Device is Ready to Pair");

  Serial.println("Waiting For Wifi Updates 30 seconds");
  ESP_BT.begin("ESP32_BLUETOOTH"); //Name of your Bluetooth Signal

while(!check_wifiUpdate()==true)
{
  }


    
Serial.println("The Stored Wifi credetial are : ");
for(int i=0;i<50;i++)
 {val=EEPROM.read(i);
 stream+=(char)val;
if((val==10) && (indS==0))
{
  indS=i;
//Serial.println("indS"+(String)i);
}
  else if(val==10 && indP==0)
  {
    indP=i;
    break;
//Serial.println("indP"+(String)i);
    }
}


// Serial.println(stream);
// Serial.println("Stream Ended");
 temp=stream.substring(0,indS);
 temp=temp.substring(5,indS);


//ssid2=ssid;
temp2=stream.substring(indS+1,indP);
temp2=temp2.substring(5,indP-indS);



  


int i=temp.length();
int j=temp2.length();
char ssid[i];
char pass[j]; 
temp.toCharArray(ssid,i);
temp2.toCharArray(pass,j);



  Serial.println("Stored SSID");
  Serial.println(ssid);
    Serial.println("Stored PASS");
  Serial.println(pass);
WiFi.mode(WIFI_STA);
WiFi.begin(ssid, pass);

 if (WiFi.waitForConnectResult() != WL_CONNECTED) {
        Serial.println("WiFi Failed");
        while(1) {
            delay(1000);
        }
    }
    else 
    {
      Serial.print("Wifi Connected to ");
      Serial.println(ssid);

}}



boolean check_wifiUpdate()
{
  unsigned long currentMillis = millis();

  if (currentMillis - previousMillis >= interval) {
    previousMillis = currentMillis;
   

    Serial.println("30 Seconds Over");

    return true;
  }

    else if (ESP_BT.available()) //Check if we receive anything from Bluetooth
  {interval=50000;
    buffer_in = ESP_BT.readStringUntil('\n'); //Read what we recevive 
    //Serial.println("Received:"); Serial.println(buffer_in);
 delay(20);
 

 if(buffer_in.charAt(0)=='S')
{
 for(int i=0;i<buffer_in.length();i++)
 {val=(byte)(buffer_in.charAt(i));
 //Serial.println("val "+val);

  EEPROM.write(addr, val);
  //Serial.println(val);
   addr++;
}
//Serial.print("New ");
//Serial.print(buffer_in);
EEPROM.write(addr, 10);
addr++;
EEPROM.commit();     
   ESP_BT.println("SSID Stored");
  }

 else if(buffer_in.charAt(0)=='P')
{
 for(int i=0;i<buffer_in.length();i++)
 {val=(byte)(buffer_in.charAt(i));
 //Serial.println("val "+val);
  EEPROM.write(addr, val);
  //Serial.println(val);
  addr++;
  
}
//Serial.print("New ");
//Serial.print(buffer_in);
EEPROM.write(addr, 10);
EEPROM.commit();  
ESP_BT.println("Password Stored"); 
 return true;
  }  
 
  return false;
  }
else
{ return false;
  }
  }
  



void loop() {
  
  
}
